kekyo/Pixy/Pixy-68000/Pixy-68000-1/Images/Pixy-68000-1-sch.pdf

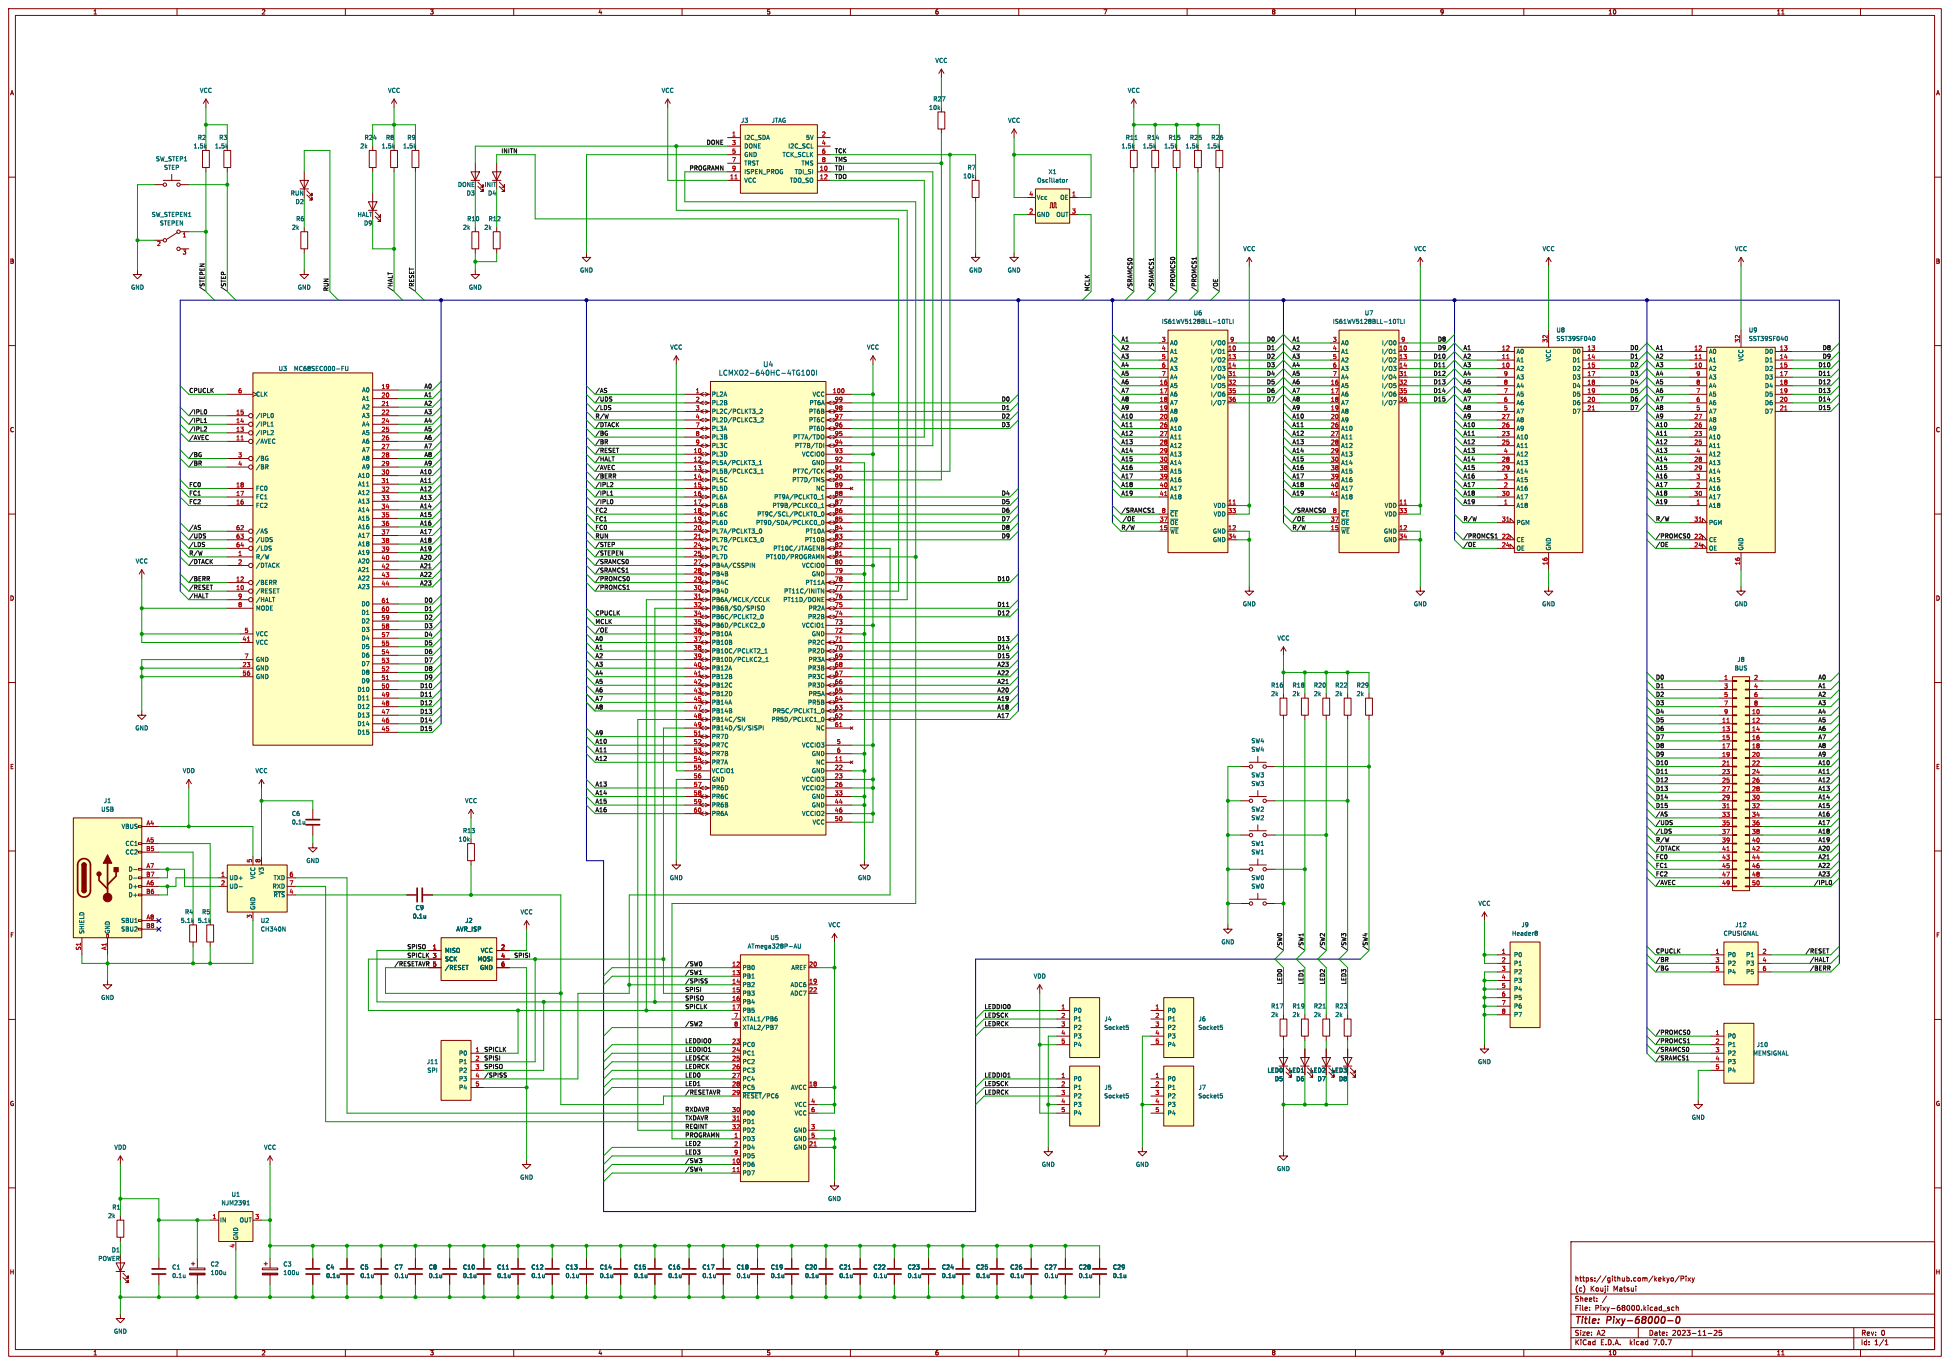
[picture p28: page 1]
