kekyo/Pixy/Pixy-68000/Pixy-68000-0/Images/Pixy-68000-0-sch.pdf

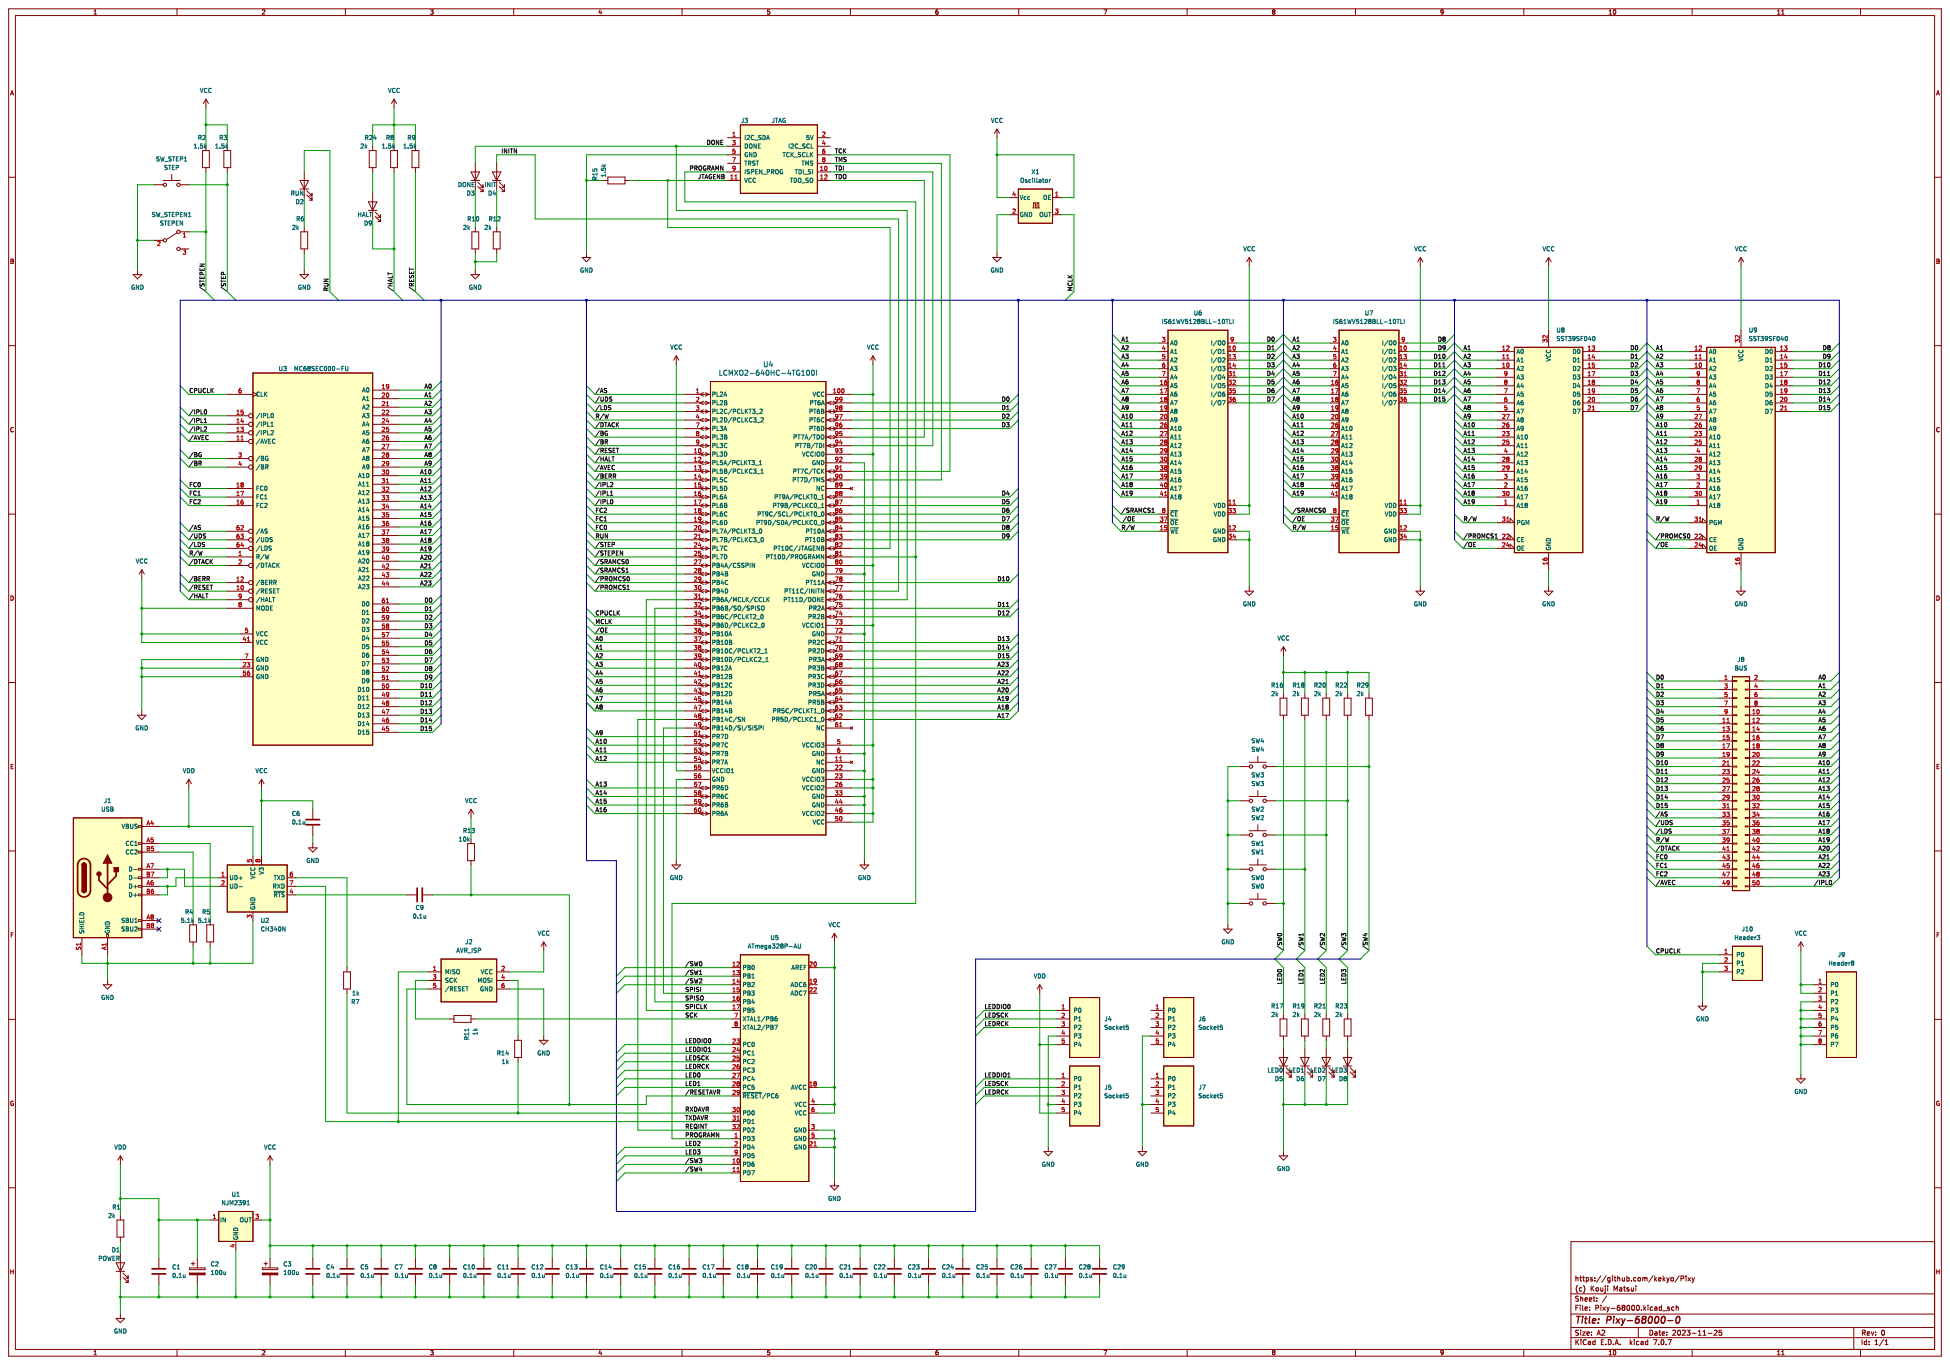
[picture p29: page 1]
