kekyo/Pixy/Pixy-68000/Pixy-68020-0/KiCad/Pixy-68020.kicad_pcb

## KiCad design Pixy-68000/Pixy-68020-0/KiCad/Pixy-68020.kicad_pcb (2025-05-06)

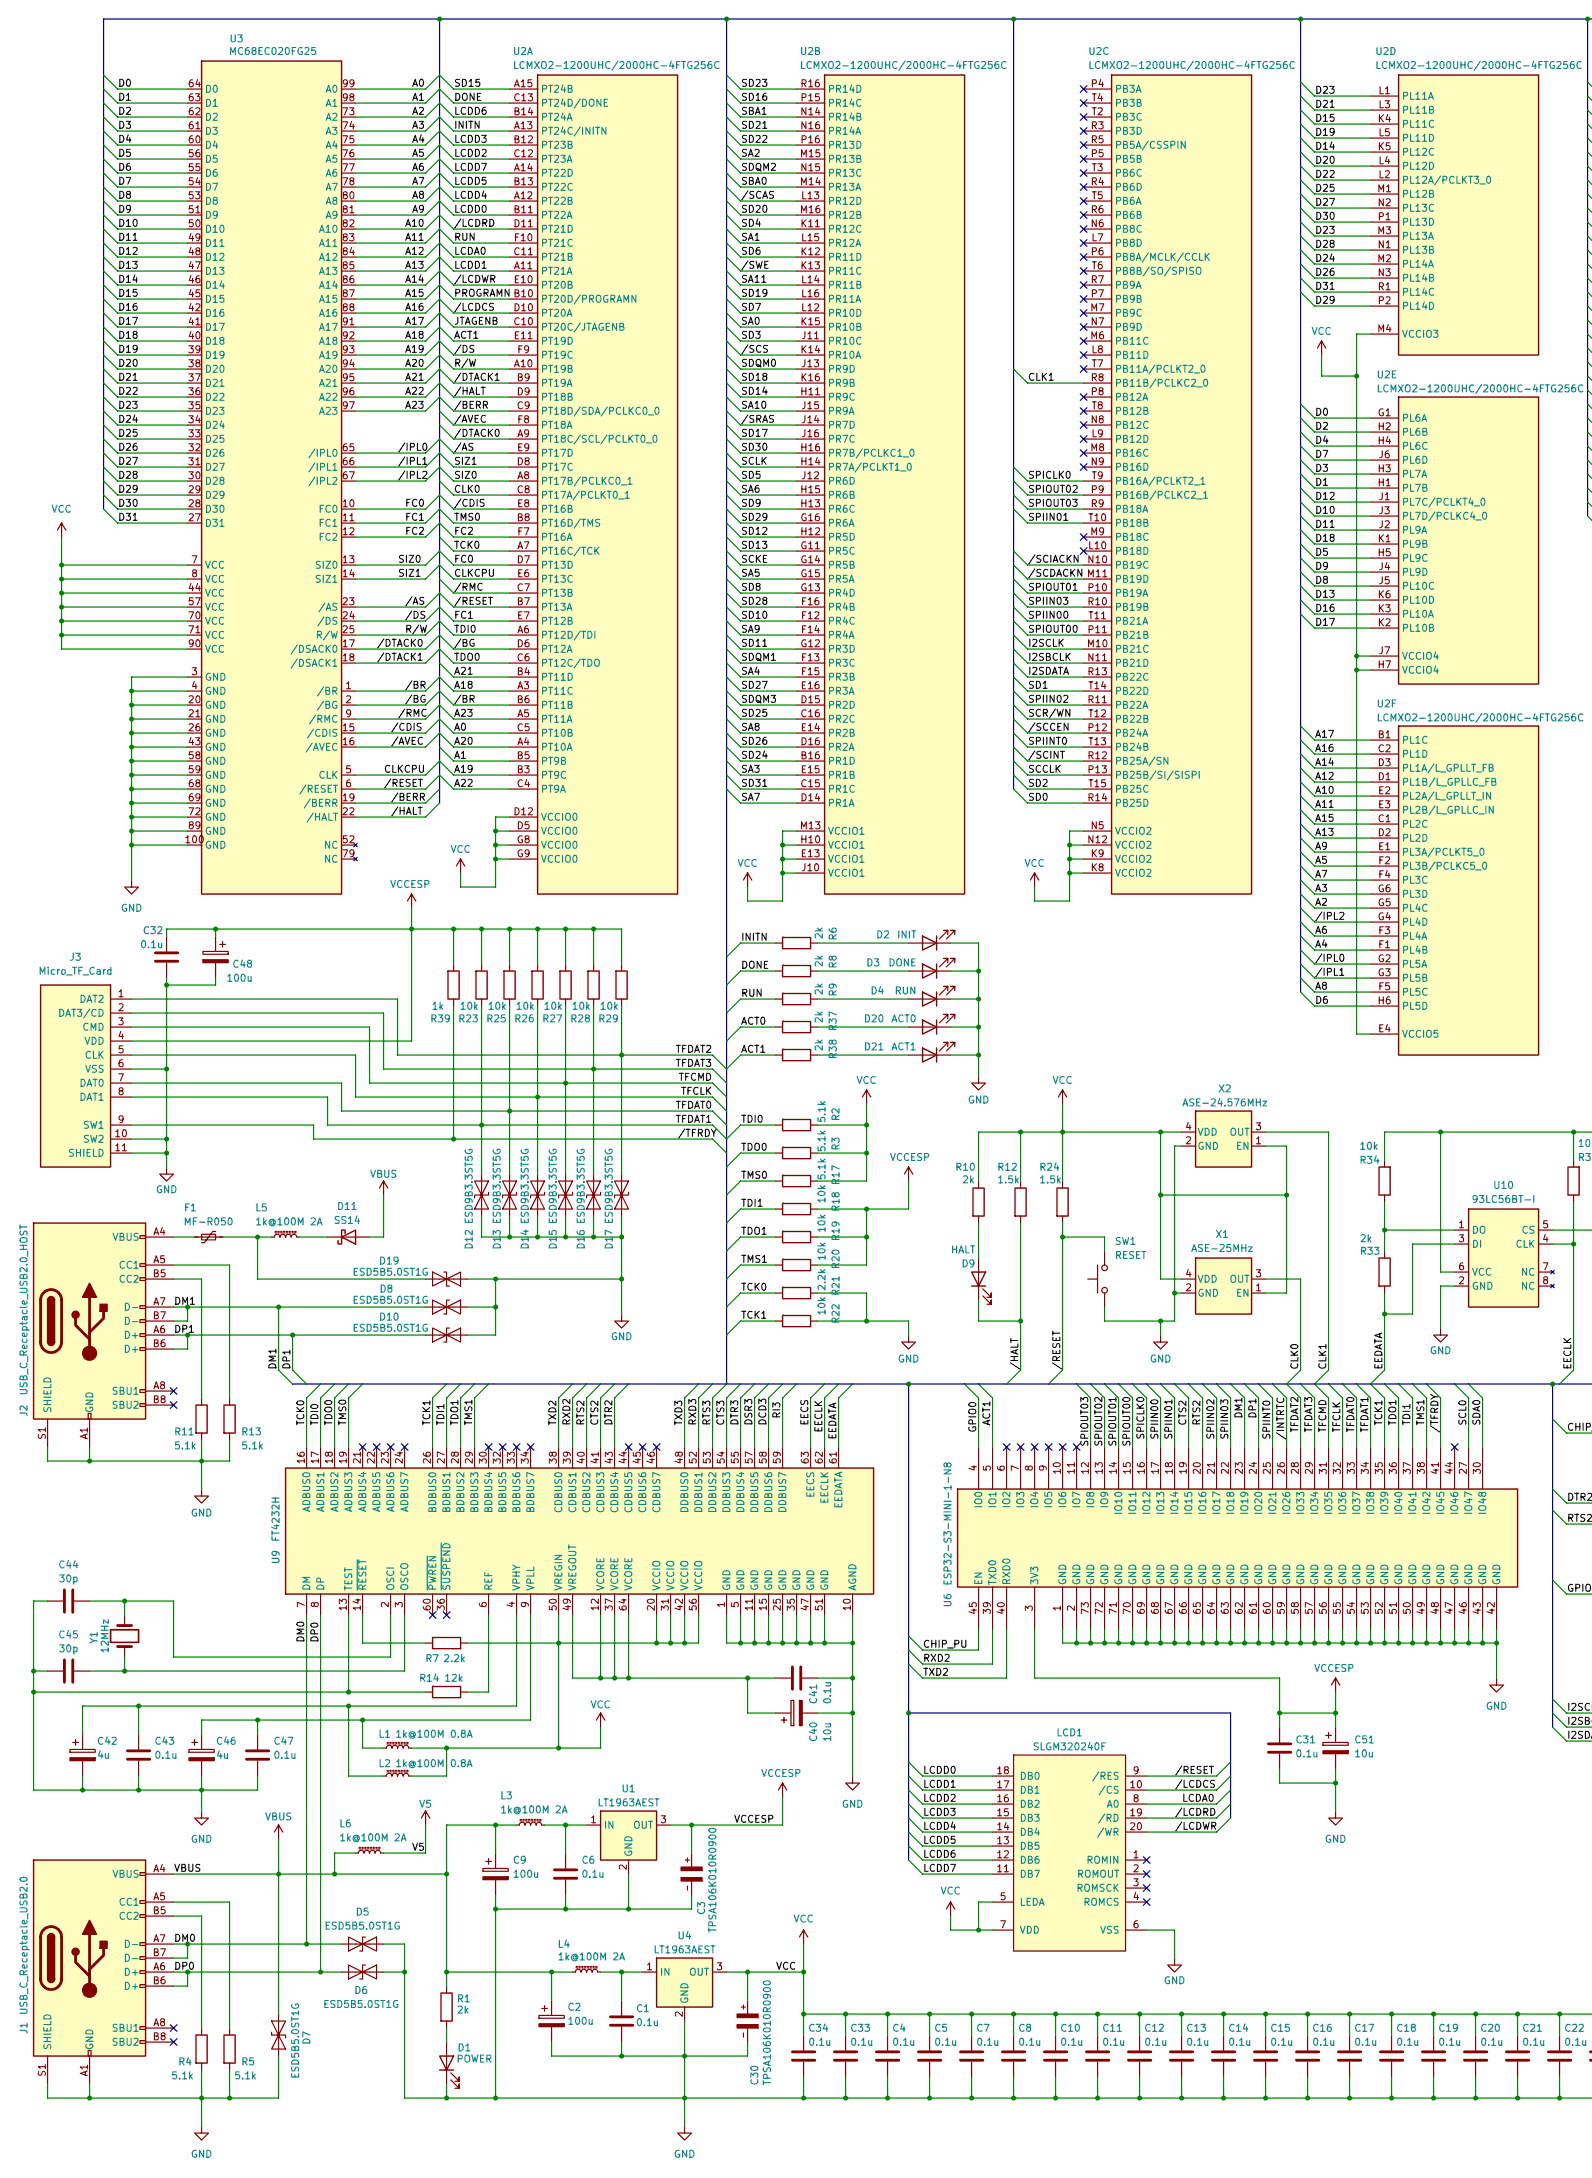
[picture p30: schematic Pixy-68020.kicad_sch, Pixy-68020-0, part in row 1, column 1]

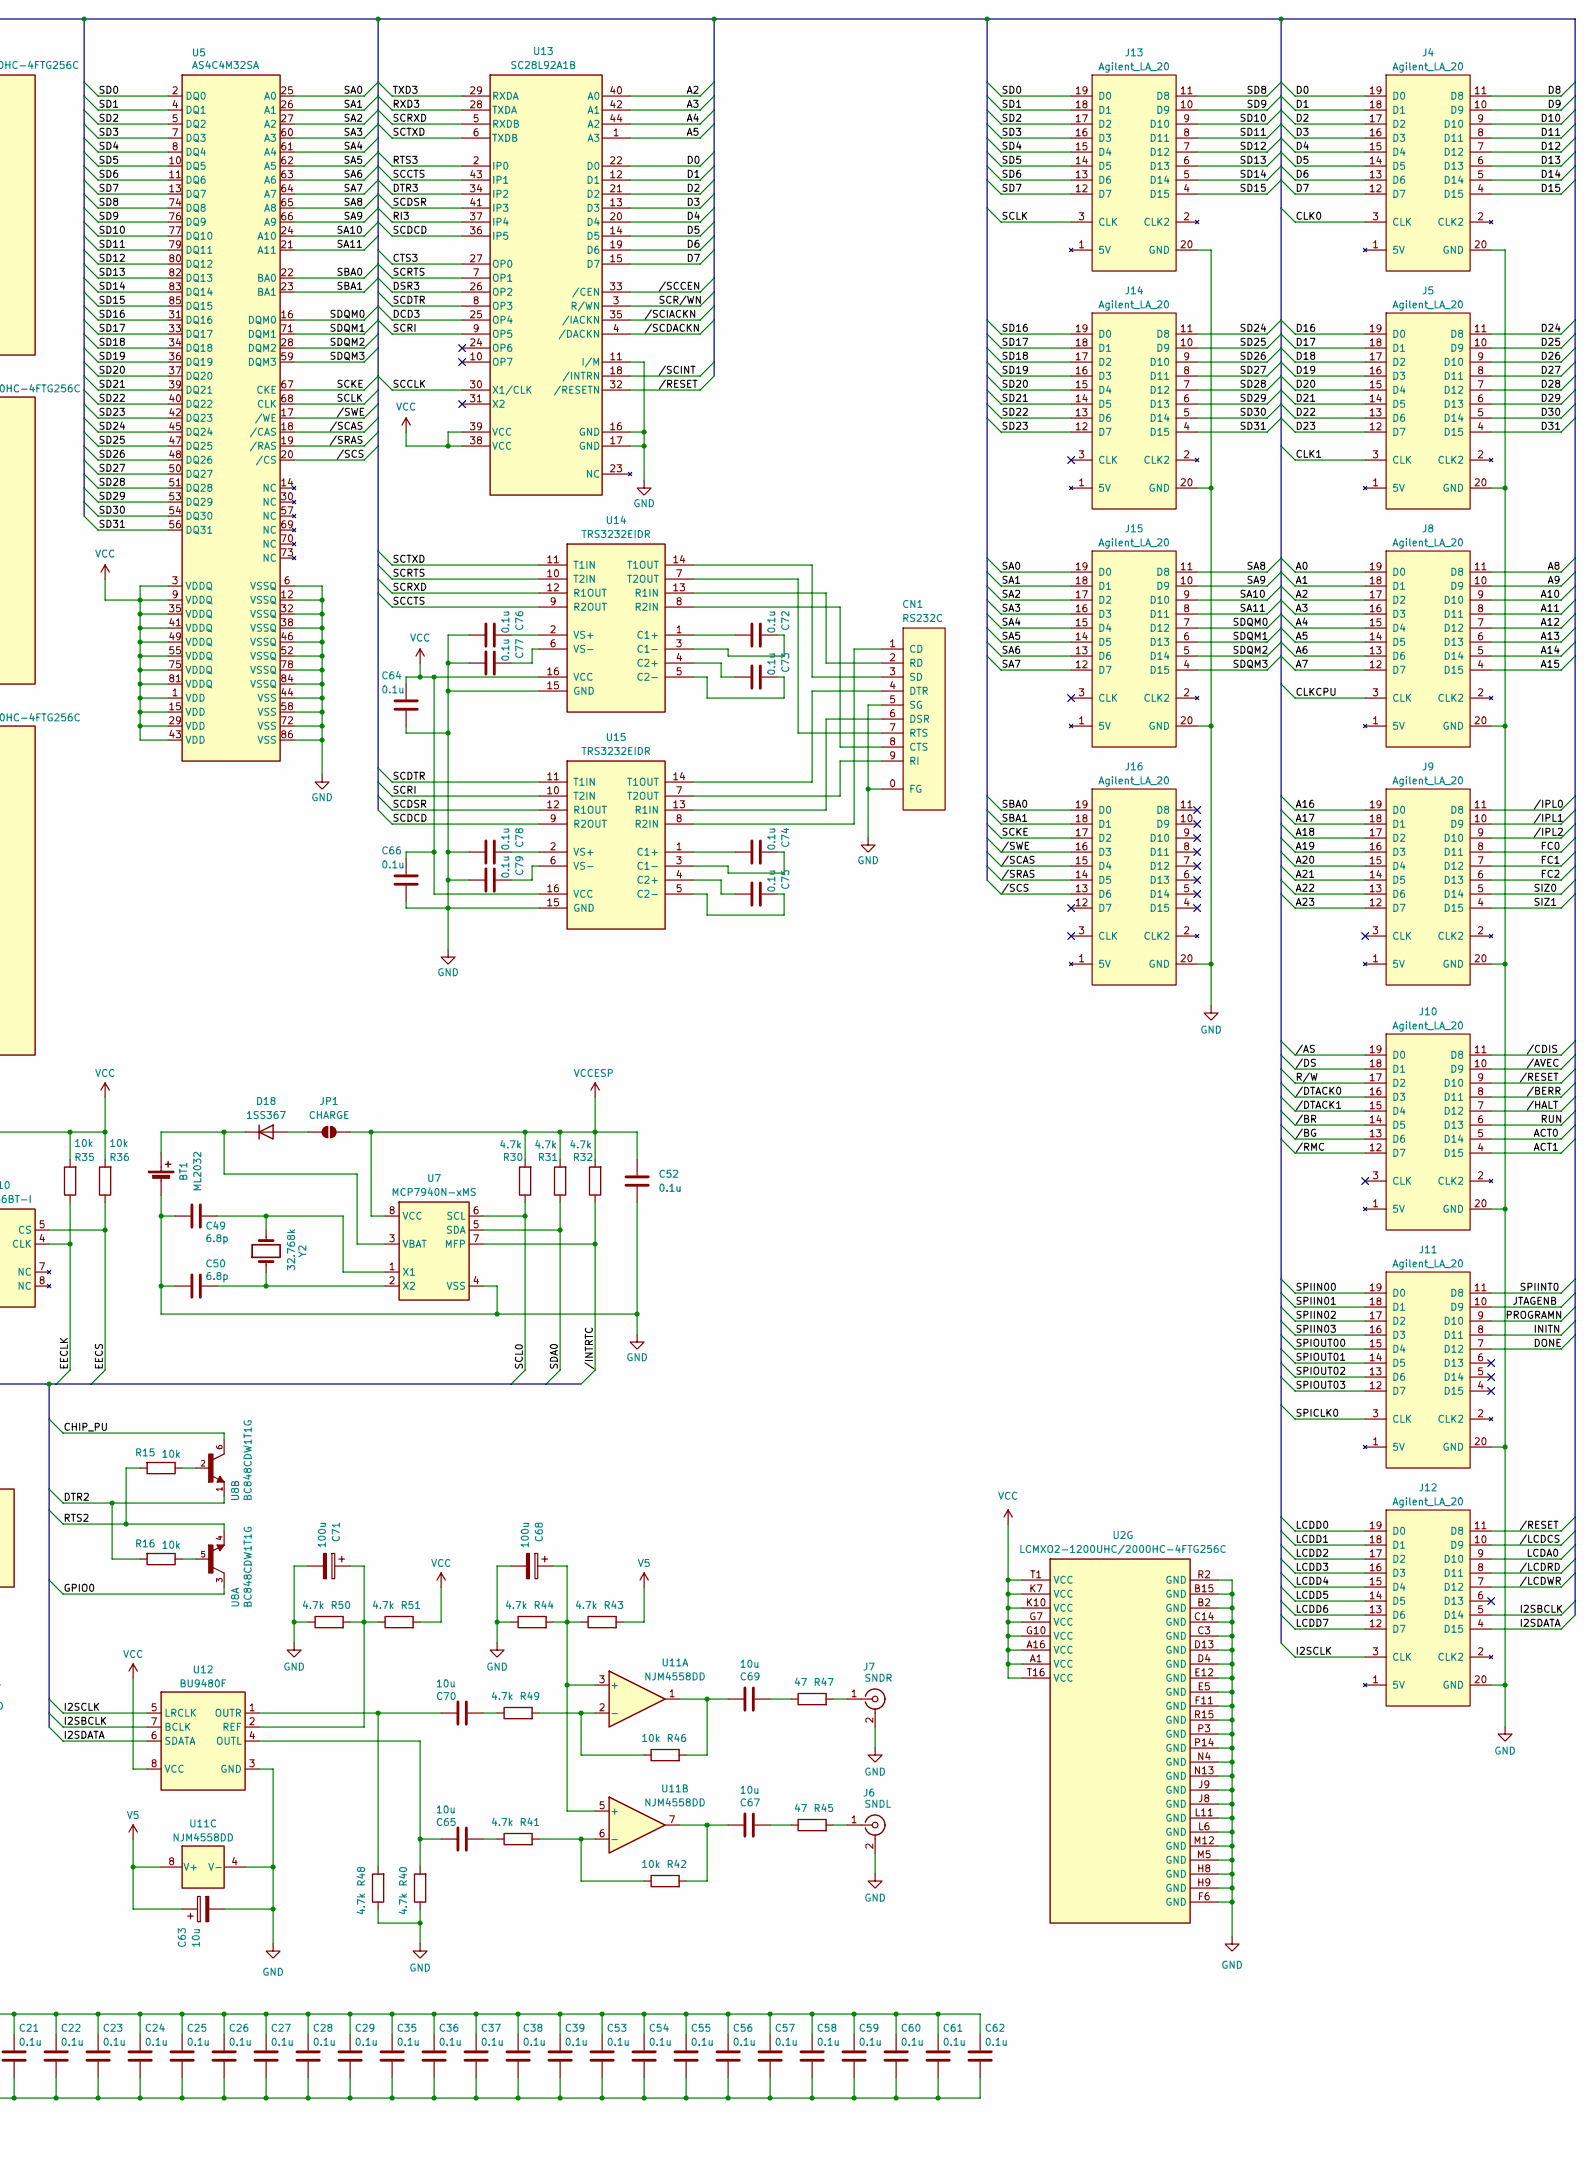
[picture p31: schematic Pixy-68020.kicad_sch, Pixy-68020-0, part in row 1, column 2]

Parts:
BT1: ML2032; BatteryHolder_Keystone_103_1x20mm
C1, C4, C5, C6, C7, C8, C10, C11, C12, C13, C14, C15, C16, C17, C18, C19, C20, C21, C22, C23, C24, C25, C26, C27, C28, C29, C31, C32, C33, C34, C35, C36, C37, C38, C39, C41, C43, C47, C52, C53, C54, C55, C56, C57, C58, C59, C60, C61, C62, C64, C66, C72, C73, C74, C75, C76, C77, C78, C79: 0.1u; C_0805_2012
C2, C9, C48, C68, C71: 100u; CP_Radial_D5.0mm_P2.50mm
C3, C30: TPSA106K010R0900; CAPMP3216X166
C40, C51, C63: 10u; CP_Radial_D5.0mm_P2.50mm
C42, C46: 4u; CP_Radial_D5.0mm_P2.50mm
C44, C45: 30p; C_0805_2012
C49, C50: 6.8p; C_0805_2012
C65, C67, C69, C70: 10u; C_0805_2012
CN1: RS232C; DSUB-9_Pins_Horizontal_P2.77x2.84mm_EdgePinOffset4.94mm_Hou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
D1: POWER; LED_D3.0mm
D2: INIT; LED_D3.0mm
D3: DONE; LED_D3.0mm
D4: RUN; LED_D3.0mm
D5, D6, D7, D8, D10, D19: ESD5B5.0ST1G; D_SOD-523
D9: HALT; LED_D3.0mm
D11: SS14; D_SMA
D12, D13, D14, D15, D16, D17: ESD9B3.3ST5G; D_SOD-923
D18: 1SS367; D_SOD-323F
D20: ACT0; LED_D3.0mm
D21: ACT1; LED_D3.0mm
F1: MF-R050; Fuse_Bourns_MF-RG300
J1: USB_C_Receptacle_USB2.0; USB_C_Receptacle_HRO_TYPE-C-31-M-12
J2: USB_C_Receptacle_USB2.0_HOST; USB_C_Receptacle_HRO_TYPE-C-31-M-12
J3: Micro_TF_Card; Hirose_DM3D-SF
J4, J5, J8, J9, J10, J11, J12, J13, J14, J15, J16: Agilent_LA_20; PinHeader_2x10_P2.54mm_Vertical
J6: SNDL; CUI_RCJ-042
J7: SNDR; CUI_RCJ-042
JP1: CHARGE; SolderJumper-2_P1.3mm_Open_RoundedPad1.0x1.5mm
L1, L2: 1k@100M 0.8A; L_0603_1608
L3, L4, L5, L6: 1k@100M 2A; L_1206_3216
LCD1: SLGM320240F; PinHeader_1x20_P2.54mm_Vertical
R1, R6, R8, R9, R10, R33, R37, R38: 2k; R_0805_2012
R2, R3, R4, R5, R11, R13, R17: 5.1k; R_0805_2012
R7, R21: 2.2k; R_0805_2012
R12, R24: 1.5k; R_0805_2012
R14: 12k; R_0805_2012
R15, R16, R18, R19, R20, R22, R23, R25, R26, R27, R28, R29, R34, R35, R36, R42, R46: 10k; R_0805_2012
R30, R31, R32, R40, R41, R43, R44, R48, R49, R50, R51: 4.7k; R_0805_2012
R39: 1k; R_0805_2012
R45, R47: 47; R_0805_2012
SW1: RESET; TactSwitch
U1, U4: LT1963AEST; SOT-223-3_TabPin2
U2: LCMXO2-1200UHC/2000HC-4FTG256C; LCMXO2-FTG256
U3: MC68EC020FG25
U5: AS4C4M32SA; SOIC-86
U6: ESP32-S3-MINI-1-N8; ESP32-S3-MINI-1_EXP
U7: MCP7940N-xMS; MSOP-8_3x3mm_P0.65mm
U8: BC848CDW1T1G; SOT65P210X110-6N
U9: FT4232H; LQFP-64_10x10mm_P0.5mm
U10: 93LC56BT-I; MSOP-8_3x3mm_P0.65mm
U11: NJM4558DD; DIP-8_W7.62mm
U12: BU9480F; SOP-8_3.9x4.9mm_P1.27mm
U13: SC28L92A1B; SOT307-2_NXP-M
U14, U15: TRS3232EIDR; SOIC-16_3.9x9.9mm_P1.27mm
X1: ASE-25MHz; Oscillator_SMD_Abracon_ASE-4Pin_3.2x2.5mm_HandSoldering
X2: ASE-24.576MHz; Oscillator_SMD_Abracon_ASE-4Pin_3.2x2.5mm_HandSoldering
Y1: 12MHz; Crystal_HC18-U_Vertical
Y2: 32.768k; Crystal_HC18-U_Vertical

Connections:
/A0: J8.19 (D0), U2.C5 (PT10B), U3.99 (A0)
/A1: J8.18 (D1), U2.B5 (PT9B), U3.98 (A1)
/A2: J8.17 (D2), U2.G5 (PL4C), U3.73 (A2), U13.40 (A0)
/A3: J8.16 (D3), U2.G6 (PL3D), U3.74 (A3), U13.42 (A1)
/A4: J8.15 (D4), U2.F1 (PL4B), U3.75 (A4), U13.44 (A2)
/A5: J8.14 (D5), U2.F2 (PL3B/PCLKC5_0), U3.76 (A5), U13.1 (A3)
/A6: J8.13 (D6), U2.F3 (PL4A), U3.77 (A6)
/A7: J8.12 (D7), U2.F4 (PL3C), U3.78 (A7)
/A8: J8.11 (D8), U2.F5 (PL5C), U3.80 (A8)
/A9: J8.10 (D9), U2.E1 (PL3A/PCLKT5_0), U3.81 (A9)
/A10: J8.9 (D10), U2.E2 (PL2A/L_GPLLT_IN), U3.82 (A10)
/A11: J8.8 (D11), U2.E3 (PL2B/L_GPLLC_IN), U3.83 (A11)
/A12: J8.7 (D12), U2.D1 (PL1B/L_GPLLC_FB), U3.84 (A12)
/A13: J8.6 (D13), U2.D2 (PL2D), U3.85 (A13)
/A14: J8.5 (D14), U2.D3 (PL1A/L_GPLLT_FB), U3.86 (A14)
/A15: J8.4 (D15), U2.C1 (PL2C), U3.87 (A15)
/A16: J9.19 (D0), U2.C2 (PL1D), U3.88 (A16)
/A17: J9.18 (D1), U2.B1 (PL1C), U3.91 (A17)
/A18: J9.17 (D2), U2.A3 (PT11C), U3.92 (A18)
/A19: J9.16 (D3), U2.B3 (PT9C), U3.93 (A19)
/A20: J9.15 (D4), U2.A4 (PT10A), U3.94 (A20)
/A21: J9.14 (D5), U2.B4 (PT11D), U3.95 (A21)
/A22: J9.13 (D6), U2.C4 (PT9A), U3.96 (A22)
/A23: J9.12 (D7), U2.A5 (PT11A), U3.97 (A23)
/ACT0: J10.5 (D14), R37.2
/ACT1: J10.4 (D15), R38.2, U2.E11 (PT19D), U6.5 (IO1)
/CHIP_PU: U6.45 (EN), U8.6
/CLK0: J4.3 (CLK), U2.C8 (PT17A/PCLKT0_1), X1.3 (OUT)
/CLK1: J5.3 (CLK), U2.R8 (PB11B/PCLKC2_0), X2.3 (OUT)
/CLKCPU: J8.3 (CLK), U2.E6 (PT13C), U3.5 (CLK)
/CTS2: U6.19 (IO15), U9.41 (CDBUS3)
/CTS3: U9.54 (DDBUS3), U13.27 (OP0)
/D0: J4.19 (D0), U2.G1 (PL6A), U3.64 (D0), U13.22 (D0)
/D1: J4.18 (D1), U2.H1 (PL7B), U3.63 (D1), U13.12 (D1)
/D2: J4.17 (D2), U2.H2 (PL6B), U3.62 (D2), U13.21 (D2)
/D3: J4.16 (D3), U2.H3 (PL7A), U3.61 (D3), U13.13 (D3)
/D4: J4.15 (D4), U2.H4 (PL6C), U3.60 (D4), U13.20 (D4)
/D5: J4.14 (D5), U2.H5 (PL9C), U3.56 (D5), U13.14 (D5)
/D6: J4.13 (D6), U2.H6 (PL5D), U3.55 (D6), U13.19 (D6)
/D7: J4.12 (D7), U2.J6 (PL6D), U3.54 (D7), U13.15 (D7)
/D8: J4.11 (D8), U2.J5 (PL10C), U3.53 (D8)
/D9: J4.10 (D9), U2.J4 (PL9D), U3.51 (D9)
/D10: J4.9 (D10), U2.J3 (PL7D/PCLKC4_0), U3.50 (D10)
/D11: J4.8 (D11), U2.J2 (PL9A), U3.49 (D11)
/D12: J4.7 (D12), U2.J1 (PL7C/PCLKT4_0), U3.48 (D12)
/D13: J4.6 (D13), U2.K6 (PL10D), U3.47 (D13)
/D14: J4.5 (D14), U2.K5 (PL12C), U3.46 (D14)
/D15: J4.4 (D15), U2.K4 (PL11C), U3.45 (D15)
/D16: J5.19 (D0), U2.K3 (PL10A), U3.42 (D16)
/D17: J5.18 (D1), U2.K2 (PL10B), U3.41 (D17)
/D18: J5.17 (D2), U2.K1 (PL9B), U3.40 (D18)
/D19: J5.16 (D3), U2.L5 (PL11D), U3.39 (D19)
/D20: J5.15 (D4), U2.L4 (PL12D), U3.38 (D20)
/D21: J5.14 (D5), U2.L3 (PL11B), U3.37 (D21)
/D22: J5.13 (D6), U2.L2 (PL12A/PCLKT3_0), U3.36 (D22)
/D23: J5.12 (D7), U2.L1 (PL11A), U2.M3 (PL13A), U3.35 (D23)
/D24: J5.11 (D8), U2.M2 (PL14A), U3.34 (D24)
/D25: J5.10 (D9), U2.M1 (PL12B), U3.33 (D25)
/D26: J5.9 (D10), U2.N3 (PL14B), U3.32 (D26)
/D27: J5.8 (D11), U2.N2 (PL13C), U3.31 (D27)
/D28: J5.7 (D12), U2.N1 (PL13B), U3.30 (D28)
/D29: J5.6 (D13), U2.P2 (PL14D), U3.29 (D29)
/D30: J5.5 (D14), U2.P1 (PL13D), U3.28 (D30)
/D31: J5.4 (D15), U2.R1 (PL14C), U3.27 (D31)
/DCD3: U9.58 (DDBUS6), U13.25 (OP4)
/DM0: D5.1 (A1), J1.A7 (D-), J1.B7 (D-), U9.7 (DM)
/DM1: D8.1 (A1), J2.A7 (D-), J2.B7 (D-), U6.23 (IO19)
/DONE: J11.7 (D12), R8.2, U2.C13 (PT24D/DONE)
/DP0: D6.1 (A1), J1.A6 (D+), J1.B6 (D+), U9.8 (DP)
/DP1: D10.1 (A1), J2.A6 (D+), J2.B6 (D+), U6.24 (IO20)
/DSR3: U9.57 (DDBUS5), U13.26 (OP2)
/DTR2: R16.2, U8.1, U9.43 (CDBUS4)
/DTR3: U9.55 (DDBUS4), U13.34 (IP2)
/EECLK: R35.1, U9.62 (EECLK), U10.4 (CLK)
/EECS: R36.1, U9.63 (EECS), U10.5 (CS)
/EEDATA: R33.2, U9.61 (EEDATA), U10.3 (DI)
/FC0: J9.8 (D11), U2.D7 (PT13D), U3.10 (FC0)
/FC1: J9.7 (D12), U2.E7 (PT12B), U3.11 (FC1)
/FC2: J9.6 (D13), U2.F7 (PT16A), U3.12 (FC2)
/GPIO0: U6.4 (IO0), U8.3
/I2SBCLK: J12.5 (D14), U2.N11 (PB21D), U12.7 (BCLK)
/I2SCLK: J12.3 (CLK), U2.M10 (PB21C), U12.5 (LRCLK)
/I2SDATA: J12.4 (D15), U2.R13 (PB22C), U12.6 (SDATA)
/INITN: J11.8 (D11), R6.2, U2.A13 (PT24C/INITN)
/JTAGENB: J11.10 (D9), U2.C10 (PT20C/JTAGENB)
/LCDA0: J12.9 (D10), LCD1.8 (A0), U2.C11 (PT21B)
/LCDD0: J12.19 (D0), LCD1.18 (DB0), U2.B11 (PT22A)
/LCDD1: J12.18 (D1), LCD1.17 (DB1), U2.A11 (PT21A)
/LCDD2: J12.17 (D2), LCD1.16 (DB2), U2.C12 (PT23A)
/LCDD3: J12.16 (D3), LCD1.15 (DB3), U2.B12 (PT23B)
/LCDD4: J12.15 (D4), LCD1.14 (DB4), U2.A12 (PT22B)
/LCDD5: J12.14 (D5), LCD1.13 (DB5), U2.B13 (PT22C)
/LCDD6: J12.13 (D6), LCD1.12 (DB6), U2.B14 (PT24A)
/LCDD7: J12.12 (D7), LCD1.11 (DB7), U2.A14 (PT22D)
/RI3: U9.59 (DDBUS7), U13.37 (IP4)
/RTS2: R15.2, U6.20 (IO16), U8.4, U9.40 (CDBUS2)
/RTS3: U9.53 (DDBUS2), U13.2 (IP0)
/RUN: J10.6 (D13), R9.2, U2.F10 (PT21C)
/RXD2: U6.39 (TXD0), U9.39 (CDBUS1)
/RXD3: U9.52 (DDBUS1), U13.28 (TXDA)
/R/W: J10.17 (D2), U2.A10 (PT19B), U3.25 (R/W)
/SA0: J15.19 (D0), U2.K15 (PR10B), U5.25 (A0)
/SA1: J15.18 (D1), U2.L15 (PR12A), U5.26 (A1)
/SA2: J15.17 (D2), U2.M15 (PR13B), U5.27 (A2)
/SA3: J15.16 (D3), U2.E15 (PR1B), U5.60 (A3)
/SA4: J15.15 (D4), U2.F15 (PR3B), U5.61 (A4)
/SA5: J15.14 (D5), U2.G15 (PR5A), U5.62 (A5)
/SA6: J15.13 (D6), U2.H15 (PR6B), U5.63 (A6)
/SA7: J15.12 (D7), U2.D14 (PR1A), U5.64 (A7)
/SA8: J15.11 (D8), U2.E14 (PR2B), U5.65 (A8)
/SA9: J15.10 (D9), U2.F14 (PR4A), U5.66 (A9)
/SA10: J15.9 (D10), U2.J15 (PR9A), U5.24 (A10)
/SA11: J15.8 (D11), U2.L14 (PR11B), U5.21 (A11)
/SBA0: J16.19 (D0), U2.M14 (PR13A), U5.22 (BA0)
/SBA1: J16.18 (D1), U2.N14 (PR14B), U5.23 (BA1)
/SCCLK: U2.P13 (PB25B/SI/SISPI), U13.30 (X1/CLK)
/SCCTS: U13.43 (IP1), U14.9 (R2OUT)
/SCDCD: U13.36 (IP5), U15.9 (R2OUT)
/SCDSR: U13.41 (IP3), U15.12 (R1OUT)
/SCDTR: U13.8 (OP3), U15.11 (T1IN)
/SCKE: J16.17 (D2), U2.G14 (PR5B), U5.67 (CKE)
/SCL0: R30.1, U6.27 (IO47), U7.6 (SCL)
/SCLK: J13.3 (CLK), U2.H14 (PR7A/PCLKT1_0), U5.68 (CLK)
/SCRI: U13.9 (OP5), U15.10 (T2IN)
/SCRTS: U13.7 (OP1), U14.10 (T2IN)
/SCRXD: U13.5 (RXDB), U14.12 (R1OUT)
/SCR/WN: U2.T12 (PB22B), U13.3 (R/WN)
/SCTXD: U13.6 (TXDB), U14.11 (T1IN)
/SD0: J13.19 (D0), U2.R14 (PB25D), U5.2 (DQ0)
/SD1: J13.18 (D1), U2.T14 (PB22D), U5.4 (DQ1)
/SD2: J13.17 (D2), U2.T15 (PB25C), U5.5 (DQ2)
/SD3: J13.16 (D3), U2.J11 (PR10C), U5.7 (DQ3)
/SD4: J13.15 (D4), U2.K11 (PR12C), U5.8 (DQ4)
/SD5: J13.14 (D5), U2.J12 (PR6D), U5.10 (DQ5)
/SD6: J13.13 (D6), U2.K12 (PR11D), U5.11 (DQ6)
/SD7: J13.12 (D7), U2.L12 (PR10D), U5.13 (DQ7)
/SD8: J13.11 (D8), U2.G13 (PR4D), U5.74 (DQ8)
/SD9: J13.10 (D9), U2.H13 (PR6C), U5.76 (DQ9)
/SD10: J13.9 (D10), U2.F12 (PR4C), U5.77 (DQ10)
/SD11: J13.8 (D11), U2.G12 (PR3D), U5.79 (DQ11)
/SD12: J13.7 (D12), U2.H12 (PR5D), U5.80 (DQ12)
/SD13: J13.6 (D13), U2.G11 (PR5C), U5.82 (DQ13)
/SD14: J13.5 (D14), U2.H11 (PR9C), U5.83 (DQ14)
/SD15: J13.4 (D15), U2.A15 (PT24B), U5.85 (DQ15)
/SD16: J14.19 (D0), U2.P15 (PR14C), U5.31 (DQ16)
/SD17: J14.18 (D1), U2.J16 (PR7C), U5.33 (DQ17)
/SD18: J14.17 (D2), U2.K16 (PR9B), U5.34 (DQ18)
/SD19: J14.16 (D3), U2.L16 (PR11A), U5.36 (DQ19)
/SD20: J14.15 (D4), U2.M16 (PR12B), U5.37 (DQ20)
/SD21: J14.14 (D5), U2.N16 (PR14A), U5.39 (DQ21)
/SD22: J14.13 (D6), U2.P16 (PR13D), U5.40 (DQ22)
/SD23: J14.12 (D7), U2.R16 (PR14D), U5.42 (DQ23)
/SD24: J14.11 (D8), U2.B16 (PR1D), U5.45 (DQ24)
/SD25: J14.10 (D9), U2.C16 (PR2C), U5.47 (DQ25)
/SD26: J14.9 (D10), U2.D16 (PR2A), U5.48 (DQ26)
/SD27: J14.8 (D11), U2.E16 (PR3A), U5.50 (DQ27)
/SD28: J14.7 (D12), U2.F16 (PR4B), U5.51 (DQ28)
/SD29: J14.6 (D13), U2.G16 (PR6A), U5.53 (DQ29)
/SD30: J14.5 (D14), U2.H16 (PR7B/PCLKC1_0), U5.54 (DQ30)
/SD31: J14.4 (D15), U2.C15 (PR1C), U5.56 (DQ31)
/SDA0: R31.1, U6.30 (IO48), U7.5 (SDA)
/SDQM0: J15.7 (D12), U2.J13 (PR9D), U5.16 (DQM0)
/SDQM1: J15.6 (D13), U2.F13 (PR3C), U5.71 (DQM1)
/SDQM2: J15.5 (D14), U2.N15 (PR13C), U5.28 (DQM2)
/SDQM3: J15.4 (D15), U2.D15 (PR2D), U5.59 (DQM3)
/SIZ0: J9.5 (D14), U2.A8 (PT17B/PCLKC0_1), U3.13 (SIZ0)
/SIZ1: J9.4 (D15), U2.D8 (PT17C), U3.14 (SIZ1)
/SPICLK0: J11.3 (CLK), U2.T9 (PB16A/PCLKT2_1), U6.16 (IO12)
/SPIIN00: J11.19 (D0), U2.T11 (PB21A), U6.17 (IO13)
/SPIIN01: J11.18 (D1), U2.T10 (PB18B), U6.18 (IO14)
/SPIIN02: J11.17 (D2), U2.R11 (PB22A), U6.21 (IO17)
/SPIIN03: J11.16 (D3), U2.R10 (PB19B), U6.22 (IO18)
/SPIINT0: J11.11 (D8), U2.T13 (PB24B), U6.25 (IO21)
/SPIOUT00: J11.15 (D4), U2.P11 (PB21B), U6.15 (IO11)
/SPIOUT01: J11.14 (D5), U2.P10 (PB19A), U6.14 (IO10)
/SPIOUT02: J11.13 (D6), U2.P9 (PB16B/PCLKC2_1), U6.13 (IO9)
/SPIOUT03: J11.12 (D7), U2.R9 (PB18A), U6.12 (IO8)
/TCK0: R21.2, U2.A7 (PT16C/TCK), U9.16 (ADBUS0)
/TCK1: R22.2, U6.35 (IO39), U9.26 (BDBUS0)
/TDI0: R2.2, U2.A6 (PT12D/TDI), U9.17 (ADBUS1)
/TDI1: R18.2, U6.37 (IO41), U9.27 (BDBUS1)
/TDO0: R3.2, U2.C6 (PT12C/TDO), U9.18 (ADBUS2)
/TDO1: R19.2, U6.36 (IO40), U9.28 (BDBUS2)
/TFCLK: D14.1 (A1), J3.5 (CLK), R26.1, U6.32 (IO36)
/TFCMD: D15.1 (A1), J3.3 (CMD), R27.1, U6.31 (IO35)
/TFDAT0: D13.1 (A1), J3.7 (DAT0), R25.1, U6.33 (IO37)
/TFDAT1: D12.1 (A1), J3.8 (DAT1), R23.1, U6.34 (IO38)
/TFDAT2: D17.1 (A1), J3.1 (DAT2), R29.1, U6.28 (IO33)
/TFDAT3: D16.1 (A1), J3.2 (DAT3/CD), R28.1, U6.29 (IO34)
/TMS0: R17.2, U2.B8 (PT16D/TMS), U9.19 (ADBUS3)
/TMS1: R20.2, U6.38 (IO42), U9.29 (BDBUS3)
/TXD2: U6.40 (RXD0), U9.38 (CDBUS0)
/TXD3: U9.48 (DDBUS0), U13.29 (RXDA)
//AS: J10.19 (D0), U2.E9 (PT17D), U3.23 (/AS)
//AVEC: J10.10 (D9), U2.F8 (PT18A), U3.16 (/AVEC)
//BERR: J10.8 (D11), U2.C9 (PT18D/SDA/PCLKC0_0), U3.19 (/BERR)
//BG: J10.13 (D6), U2.D6 (PT12A), U3.2 (/BG)
//BR: J10.14 (D5), U2.B6 (PT11B), U3.1 (/BR)
//CDIS: J10.11 (D8), U2.E8 (PT16B), U3.15 (/CDIS)
//DS: J10.18 (D1), U2.F9 (PT19C), U3.24 (/DS)
//DTACK0: J10.16 (D3), U2.A9 (PT18C/SCL/PCLKT0_0), U3.17 (/DSACK0)
//DTACK1: J10.15 (D4), U2.B9 (PT19A), U3.18 (/DSACK1)
//HALT: D9.1 (K), J10.7 (D12), R12.2, U2.D9 (PT18B), U3.22 (/HALT)
//INTRTC: R32.1, U6.26 (IO26), U7.7 (MFP)
//IPL0: J9.11 (D8), U2.G2 (PL5A), U3.65 (/IPL0)
//IPL1: J9.10 (D9), U2.G3 (PL5B), U3.66 (/IPL1)
//IPL2: J9.9 (D10), U2.G4 (PL4D), U3.67 (/IPL2)
//LCDCS: J12.10 (D9), LCD1.10 (/CS), U2.D10 (PT20A)
//LCDRD: J12.8 (D11), LCD1.19 (/RD), U2.D11 (PT21D)
//LCDWR: J12.7 (D12), LCD1.20 (/WR), U2.E10 (PT20B)
//RESET: J10.9 (D10), J12.11 (D8), LCD1.9 (/RES), R24.2, SW1.2, U2.B7 (PT13A), U3.6 (/RESET), U13.32 (/RESETN)
//RMC: J10.12 (D7), U2.C7 (PT13B), U3.9 (/RMC)
//SCAS: J16.15 (D4), U2.L13 (PR12D), U5.18 (/CAS)
//SCCEN: U2.P12 (PB24A), U13.33 (/CEN)
//SCDACKN: U2.M11 (PB19D), U13.4 (/DACKN)
//SCIACKN: U2.N10 (PB19C), U13.35 (/IACKN)
//SCINT: U2.R12 (PB25A/SN), U13.18 (/INTRN)
//SCS: J16.13 (D6), U2.K14 (PR10A), U5.20 (/CS)
//SRAS: J16.14 (D5), U2.J14 (PR7D), U5.19 (/RAS)
//SWE: J16.16 (D3), U2.K13 (PR11C), U5.17 (/WE)
//TFRDY: J3.9 (SW1), R39.1, U6.41 (IO45)
GND: BT1.2 (-), C1.2, C2.2, C3.-, C4.2, C5.2, C6.2, C7.2, C8.2, C9.2, C10.2, C11.2, C12.2, C13.2, C14.2, C15.2, C16.2, C17.2, C18.2, C19.2, C20.2, C21.2, C22.2, C23.2, C24.2, C25.2, C26.2, C27.2, C28.2, C29.2, C30.-, C31.2, C32.2, C33.2, C34.2, C35.2, C36.2, C37.2, C38.2, C39.2, C40.2, C41.2, C42.2, C43.2, C44.2, C45.2, C46.2, C47.2, C48.2, C49.2, C50.2, C51.2, C52.2, C53.2, C54.2, C55.2, C56.2, C57.2, C58.2, C59.2, C60.2, C61.2, C62.2, C63.2, C64.2, C66.2, C68.2, C71.2, C76.2, C77.2, C78.2, C79.2, CN1.0 (FG), CN1.5 (SG), D1.1 (K), D2.1 (K), D3.1 (K), D4.1 (K), D5.2 (A2), D6.2 (A2), D7.2 (A2), D8.2 (A2), D10.2 (A2), D12.2 (A2), D13.2 (A2), D14.2 (A2), D15.2 (A2), D16.2 (A2), D17.2 (A2), D19.1 (A1), D20.1 (K), D21.1 (K), J1.A1 (GND), J1.A12 (GND), J1.B1 (GND), J1.B12 (GND), J1.S1 (SHIELD), J2.A1 (GND), J2.A12 (GND), J2.B1 (GND), J2.B12 (GND), J2.S1 (SHIELD), J3.6 (VSS), J3.10 (SW2), J3.11 (SHIELD), J4.20 (GND), J5.20 (GND), J6.2 (Ext), J7.2 (Ext), J8.20 (GND), J9.20 (GND), J10.20 (GND), J11.9 (D10), J11.20 (GND), J12.20 (GND), J13.20 (GND), J14.20 (GND), J15.20 (GND), J16.20 (GND), LCD1.6 (VSS), R4.2, R5.2, R11.2, R13.2, R14.2, R21.1, R22.1, R40.1, R44.1, R48.1, R50.1, SW1.1, U1.2 (GND), U2.B2 (GND), U2.B10 (PT20D/PROGRAMN), U2.B15 (GND), U2.C3 (GND), U2.C14 (GND), U2.D4 (GND), U2.D13 (GND), U2.E5 (GND), U2.E12 (GND), U2.F6 (GND), U2.F11 (GND), U2.H8 (GND), U2.H9 (GND), U2.J8 (GND), U2.J9 (GND), U2.L6 (GND), U2.L11 (GND), U2.M5 (GND), U2.M12 (GND), U2.N4 (GND), U2.N13 (GND), U2.P3 (GND), U2.P14 (GND), U2.R2 (GND), U2.R15 (GND), U3.3 (GND), U3.4 (GND), U3.20 (GND), U3.21 (GND), U3.26 (GND), U3.43 (GND), U3.58 (GND), U3.59 (GND), U3.68 (GND), U3.69 (GND), U3.72 (GND), U3.89 (GND), U3.100 (GND), U4.2 (GND), U5.6 (VSSQ), U5.12 (VSSQ), U5.32 (VSSQ), U5.38 (VSSQ), U5.44 (VSS), U5.46 (VSSQ), U5.52 (VSSQ), U5.58 (VSS), U5.72 (VSS), U5.78 (VSSQ), U5.84 (VSSQ), U5.86 (VSS), U6.1 (GND), U6.2 (GND), U6.42 (GND), U6.43 (GND), U6.46 (GND), U6.47 (GND), U6.48 (GND), U6.49 (GND), U6.50 (GND), U6.51 (GND), U6.52 (GND), U6.53 (GND), U6.54 (GND), U6.55 (GND), U6.56 (GND), U6.57 (GND), U6.58 (GND), U6.59 (GND), U6.60 (GND), U6.61 (GND), U6.62 (GND), U6.63 (GND), U6.64 (GND), U6.65 (GND), U6.66 (GND), U6.67 (GND), U6.68 (GND), U6.69 (GND), U6.70 (GND), U6.71 (GND), U6.72 (GND), U6.73 (GND), U7.4 (VSS), U9.1 (GND), U9.5 (GND), U9.10 (AGND), U9.11 (GND), U9.13 (TEST), U9.15 (GND), U9.25 (GND), U9.35 (GND), U9.47 (GND), U9.51 (GND), U10.2 (GND), U11.4 (V-), U12.3 (GND), U13.11 (I/M), U13.16 (GND), U13.17 (GND), U14.15 (GND), U15.15 (GND), X1.2 (GND), X2.2 (GND)
unnamed: BT1.1 (+), D18.1 (K), U7.3 (VBAT)
unnamed: C65.1, R41.1
unnamed: C67.1, R45.1
unnamed: C67.2, R42.2, U11.7
unnamed: C69.1, R47.1
unnamed: C69.2, R46.2, U11.1
unnamed: C70.1, R49.1
unnamed: CN1.1 (CD), U15.8 (R2IN)
unnamed: CN1.8 (CTS), U14.8 (R2IN)
unnamed: CN1.6 (DSR), U15.13 (R1IN)
unnamed: CN1.4 (DTR), U15.14 (T1OUT)
unnamed: CN1.2 (RD), U14.13 (R1IN)
unnamed: CN1.9 (RI), U15.7 (T2OUT)
unnamed: CN1.7 (RTS), U14.7 (T2OUT)
unnamed: CN1.3 (SD), U14.14 (T1OUT)
unnamed: D1.2 (A), R1.2
unnamed: D2.2 (A), R6.1
unnamed: D3.2 (A), R8.1
unnamed: D4.2 (A), R9.1
unnamed: D9.2 (A), R10.2
unnamed: D11.1 (K), L5.1
unnamed: D18.2 (A), JP1.1 (A)
unnamed: D19.2 (A2), F1.1, L5.2
unnamed: D20.2 (A), R37.1
unnamed: D21.2 (A), R38.1
unnamed: F1.2, J2.A4 (VBUS), J2.A9 (VBUS), J2.B4 (VBUS), J2.B9 (VBUS)
unnamed: J1.A5 (CC1), R5.1
unnamed: J1.B5 (CC2), R4.1
unnamed: J2.A5 (CC1), R13.1
unnamed: J2.B5 (CC2), R11.1
unnamed: J6.1 (In), R45.2
unnamed: J7.1 (In), R47.2
unnamed: R15.1, U8.2
unnamed: R16.1, U8.5
unnamed: C6.1, L3.1, U1.1 (IN)
unnamed: C1.1, L4.1, U4.1 (IN)
unnamed: C49.1, U7.1 (X1), Y2.2
unnamed: C50.1, U7.2 (X2), Y2.1
unnamed: C44.1, U9.2 (OSCI), Y1.2
unnamed: C45.1, U9.3 (OSCO), Y1.1
unnamed: R14.1, U9.6 (REF)
unnamed: C42.1, C43.1, L2.2, U9.4 (VPHY)
unnamed: C46.1, C47.1, L1.2, U9.9 (VPLL)
unnamed: C40.1, C41.1, U9.12 (VCORE), U9.37 (VCORE), U9.49 (VREGOUT), U9.64 (VCORE)
unnamed: R7.1, U9.14 (~RESET)
unnamed: R33.1, R34.1, U10.1 (DO)
unnamed: C68.1, R43.1, R44.2, U11.3 (+), U11.5 (+)
unnamed: R46.1, R49.2, U11.2 (-)
unnamed: R41.2, R42.1, U11.6 (-)
unnamed: C65.2, R40.2, U12.4 (OUTL)
unnamed: C70.2, R48.2, U12.1 (OUTR)
unnamed: C71.1, R50.2, R51.1, U12.2 (REF)
unnamed: C72.2, U14.1 (C1+)
unnamed: C72.1, U14.3 (C1-)
unnamed: C73.2, U14.4 (C2+)
unnamed: C73.1, U14.5 (C2-)
unnamed: C76.1, U14.2 (VS+)
unnamed: C77.1, U14.6 (VS-)
unnamed: C74.2, U15.1 (C1+)
unnamed: C74.1, U15.3 (C1-)
unnamed: C75.2, U15.4 (C2+)
unnamed: C75.1, U15.5 (C2-)
unnamed: C78.1, U15.2 (VS+)
unnamed: C79.1, U15.6 (VS-)
V5: C63.1, L6.1, R43.2, U11.8 (V+)
VBUS: C2.1, C9.1, D7.1 (A1), D11.2 (A), J1.A4 (VBUS), J1.A9 (VBUS), J1.B4 (VBUS), J1.B9 (VBUS), L3.2, L4.2, L6.2, R1.1
VCC: C4.1, C5.1, C7.1, C8.1, C10.1, C11.1, C12.1, C13.1, C14.1, C15.1, C16.1, C17.1, C18.1, C19.1, C20.1, C21.1, C22.1, C23.1, C24.1, C25.1, C26.1, C27.1, C28.1, C29.1, C30.+, C33.1, C34.1, C35.1, C36.1, C37.1, C38.1, C39.1, C53.1, C54.1, C55.1, C56.1, C57.1, C58.1, C59.1, C60.1, C61.1, C62.1, C64.1, C66.1, L1.1, L2.1, LCD1.5 (LEDA), LCD1.7 (VDD), R2.1, R3.1, R7.2, R10.1, R12.1, R17.1, R24.1, R34.2, R35.2, R36.2, R51.2, U2.A1 (VCC), U2.A16 (VCC), U2.D5 (VCCIO0), U2.D12 (VCCIO0), U2.E4 (VCCIO5), U2.E13 (VCCIO1), U2.G7 (VCC), U2.G8 (VCCIO0), U2.G9 (VCCIO0), U2.G10 (VCC), U2.H7 (VCCIO4), U2.H10 (VCCIO1), U2.J7 (VCCIO4), U2.J10 (VCCIO1), U2.K7 (VCC), U2.K8 (VCCIO2), U2.K9 (VCCIO2), U2.K10 (VCC), U2.M4 (VCCIO3), U2.M13 (VCCIO1), U2.N5 (VCCIO2), U2.N12 (VCCIO2), U2.T1 (VCC), U2.T16 (VCC), U3.7 (VCC), U3.8 (VCC), U3.44 (VCC), U3.57 (VCC), U3.70 (VCC), U3.71 (VCC), U3.90 (VCC), U4.3 (OUT), U5.1 (VDD), U5.3 (VDDQ), U5.9 (VDDQ), U5.15 (VDD), U5.29 (VDD), U5.35 (VDDQ), U5.41 (VDDQ), U5.43 (VDD), U5.49 (VDDQ), U5.55 (VDDQ), U5.75 (VDDQ), U5.81 (VDDQ), U9.20 (VCCIO), U9.31 (VCCIO), U9.42 (VCCIO), U9.50 (VREGIN), U9.56 (VCCIO), U10.6 (VCC), U12.8 (VCC), U13.38 (VCC), U13.39 (VCC), U14.16 (VCC), U15.16 (VCC), X1.1 (EN), X1.4 (VDD), X2.1 (EN), X2.4 (VDD)
VCCESP: C3.+, C31.1, C32.1, C48.1, C51.1, C52.1, J3.4 (VDD), JP1.2 (B), R18.1, R19.1, R20.1, R23.2, R25.2, R26.2, R27.2, R28.2, R29.2, R30.2, R31.2, R32.2, R39.2, U1.3 (OUT), U6.3 (3V3), U7.8 (VCC)

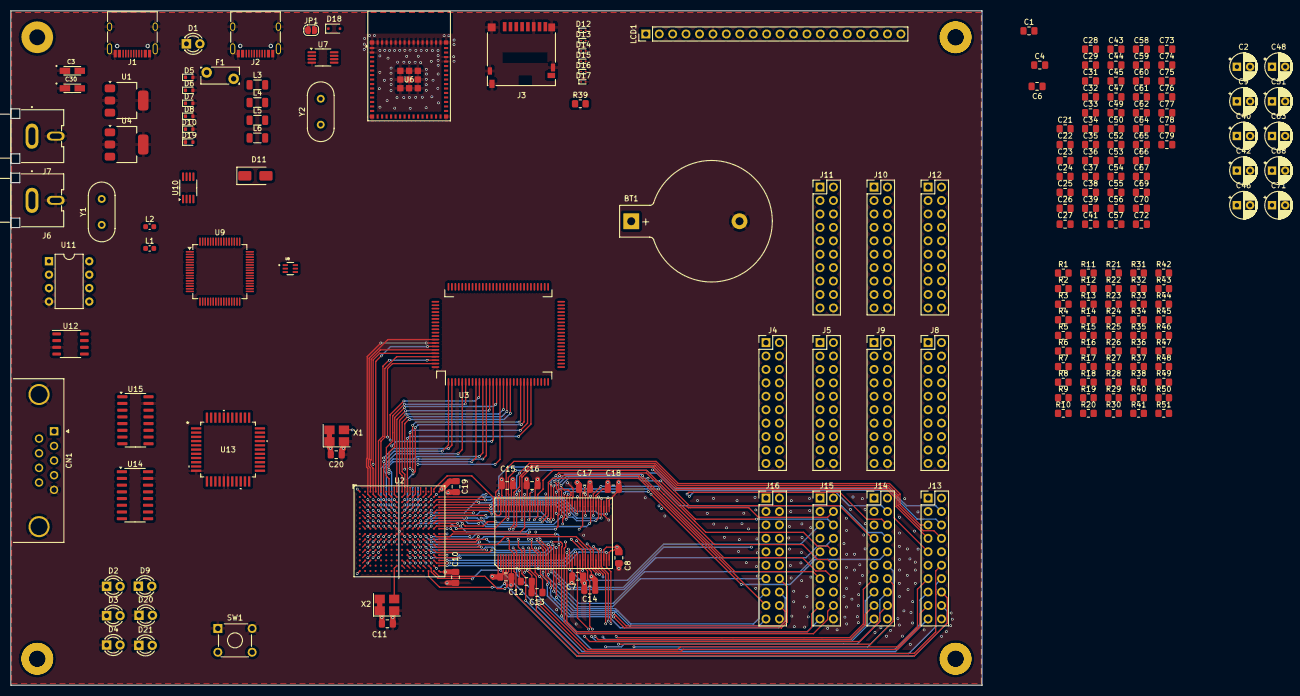
[picture p32: board Pixy-68020.kicad_pcb from above]

Board: 4 copper layers, 183.7 x 127.6 mm, 198 parts (0 on the bottom side), 290 nets.
