kekyo/Pixy/Pixy-mega128-sdram-hat/KiCad/Pixy-mega128-0-sdram-hat.kicad_pcb

## KiCad design Pixy-mega128-sdram-hat/KiCad/Pixy-mega128-0-sdram-hat.kicad_pcb (2023-11-04)

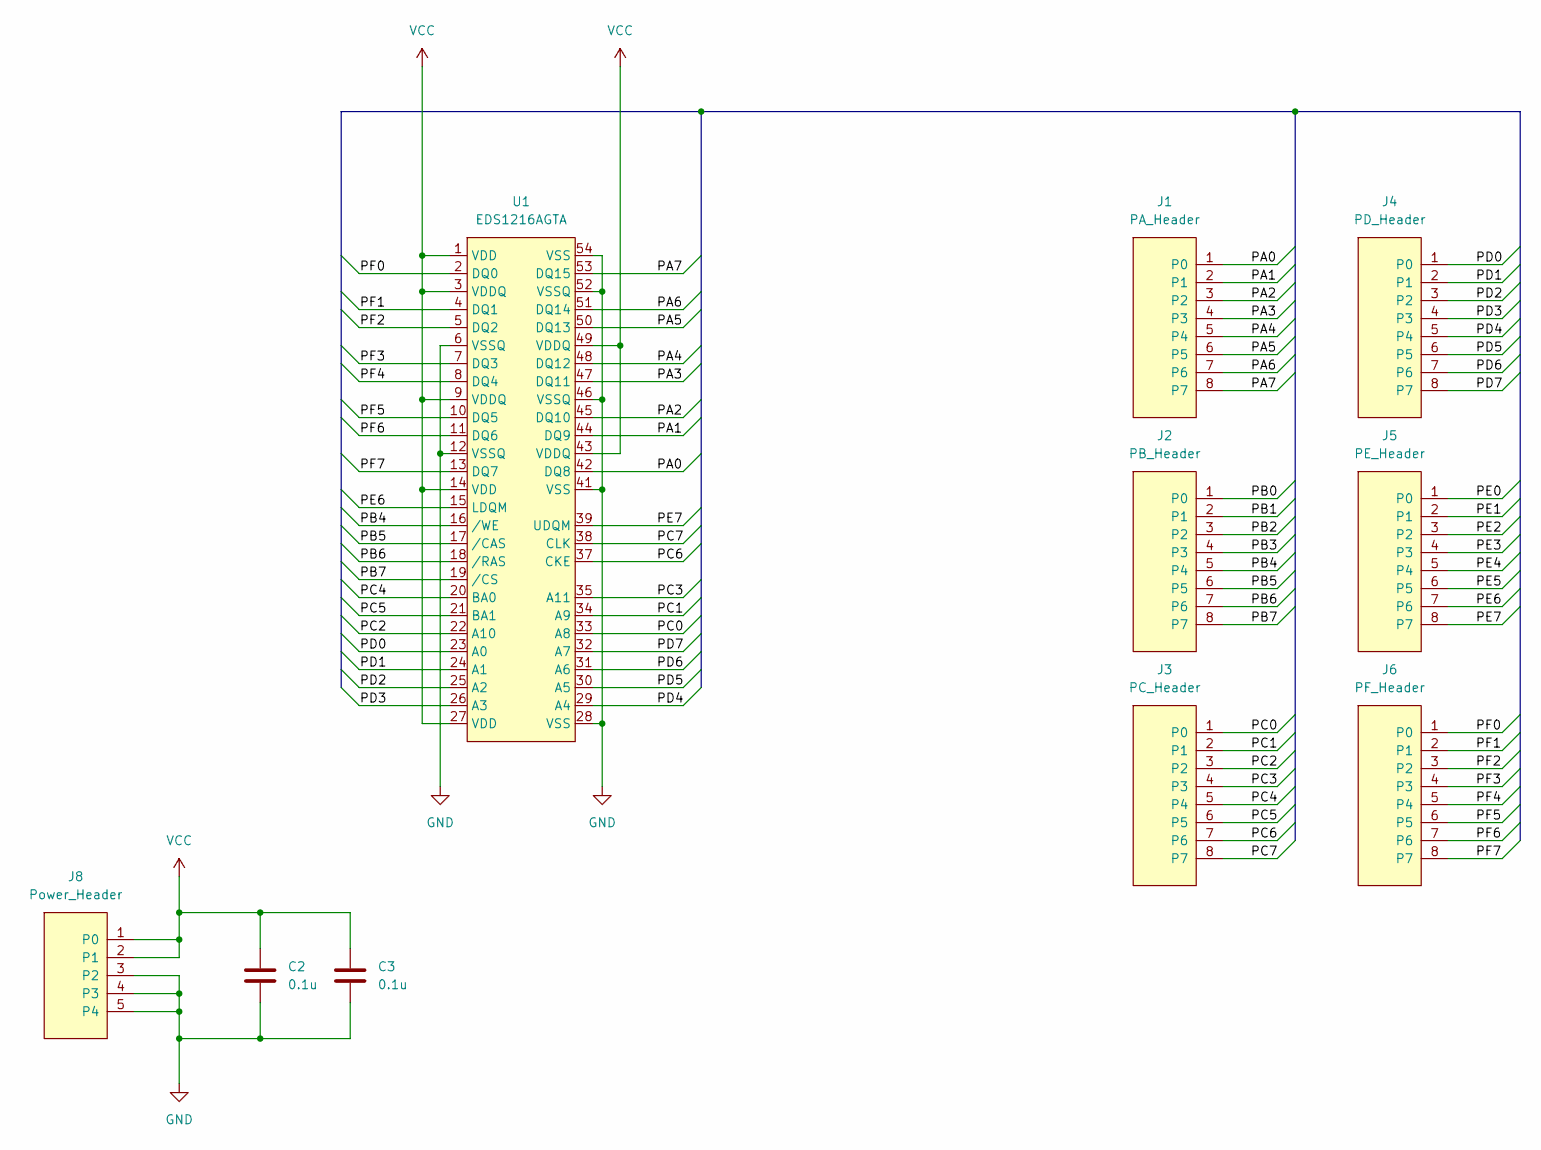
[picture p33: schematic Pixy-mega128-0-sdram-hat.kicad_sch]

Parts:
C2, C3: 0.1u; C_Disc_D4.3mm_W1.9mm_P5.00mm
J1: PA_Header; PinHeader_1x08_P2.54mm_Vertical
J2: PB_Header; PinHeader_1x08_P2.54mm_Vertical
J3: PC_Header; PinHeader_1x08_P2.54mm_Vertical
J4: PD_Header; PinHeader_1x08_P2.54mm_Vertical
J5: PE_Header; PinHeader_1x08_P2.54mm_Vertical
J6: PF_Header; PinHeader_1x08_P2.54mm_Vertical
J8: Power_Header; PinSocket_1x05_P2.54mm_Vertical
U1: EDS1216AGTA

Connections:
/PA0: J1.1 (P0), U1.42 (DQ8)
/PA1: J1.2 (P1), U1.44 (DQ9)
/PA2: J1.3 (P2), U1.45 (DQ10)
/PA3: J1.4 (P3), U1.47 (DQ11)
/PA4: J1.5 (P4), U1.48 (DQ12)
/PA5: J1.6 (P5), U1.50 (DQ13)
/PA6: J1.7 (P6), U1.51 (DQ14)
/PA7: J1.8 (P7), U1.53 (DQ15)
/PB0: J2.1 (P0)
/PB1: J2.2 (P1)
/PB2: J2.3 (P2)
/PB3: J2.4 (P3)
/PB4: J2.5 (P4), U1.16 (/WE)
/PB5: J2.6 (P5), U1.17 (/CAS)
/PB6: J2.7 (P6), U1.18 (/RAS)
/PB7: J2.8 (P7), U1.19 (/CS)
/PC0: J3.1 (P0), U1.33 (A8)
/PC1: J3.2 (P1), U1.34 (A9)
/PC2: J3.3 (P2), U1.22 (A10)
/PC3: J3.4 (P3), U1.35 (A11)
/PC4: J3.5 (P4), U1.20 (BA0)
/PC5: J3.6 (P5), U1.21 (BA1)
/PC6: J3.7 (P6), U1.37 (CKE)
/PC7: J3.8 (P7), U1.38 (CLK)
/PD0: J4.1 (P0), U1.23 (A0)
/PD1: J4.2 (P1), U1.24 (A1)
/PD2: J4.3 (P2), U1.25 (A2)
/PD3: J4.4 (P3), U1.26 (A3)
/PD4: J4.5 (P4), U1.29 (A4)
/PD5: J4.6 (P5), U1.30 (A5)
/PD6: J4.7 (P6), U1.31 (A6)
/PD7: J4.8 (P7), U1.32 (A7)
/PE0: J5.1 (P0)
/PE1: J5.2 (P1)
/PE2: J5.3 (P2)
/PE3: J5.4 (P3)
/PE4: J5.5 (P4)
/PE5: J5.6 (P5)
/PE6: J5.7 (P6), U1.15 (LDQM)
/PE7: J5.8 (P7), U1.39 (UDQM)
/PF0: J6.1 (P0), U1.2 (DQ0)
/PF1: J6.2 (P1), U1.4 (DQ1)
/PF2: J6.3 (P2), U1.5 (DQ2)
/PF3: J6.4 (P3), U1.7 (DQ3)
/PF4: J6.5 (P4), U1.8 (DQ4)
/PF5: J6.6 (P5), U1.10 (DQ5)
/PF6: J6.7 (P6), U1.11 (DQ6)
/PF7: J6.8 (P7), U1.13 (DQ7)
GND: C2.2, C3.2, J8.3 (P2), J8.4 (P3), J8.5 (P4), U1.6 (VSSQ), U1.12 (VSSQ), U1.28 (VSS), U1.41 (VSS), U1.46 (VSSQ), U1.52 (VSSQ), U1.54 (VSS)
VCC: C2.1, C3.1, J8.1 (P0), J8.2 (P1), U1.1 (VDD), U1.3 (VDDQ), U1.9 (VDDQ), U1.14 (VDD), U1.27 (VDD), U1.43 (VDDQ), U1.49 (VDDQ)

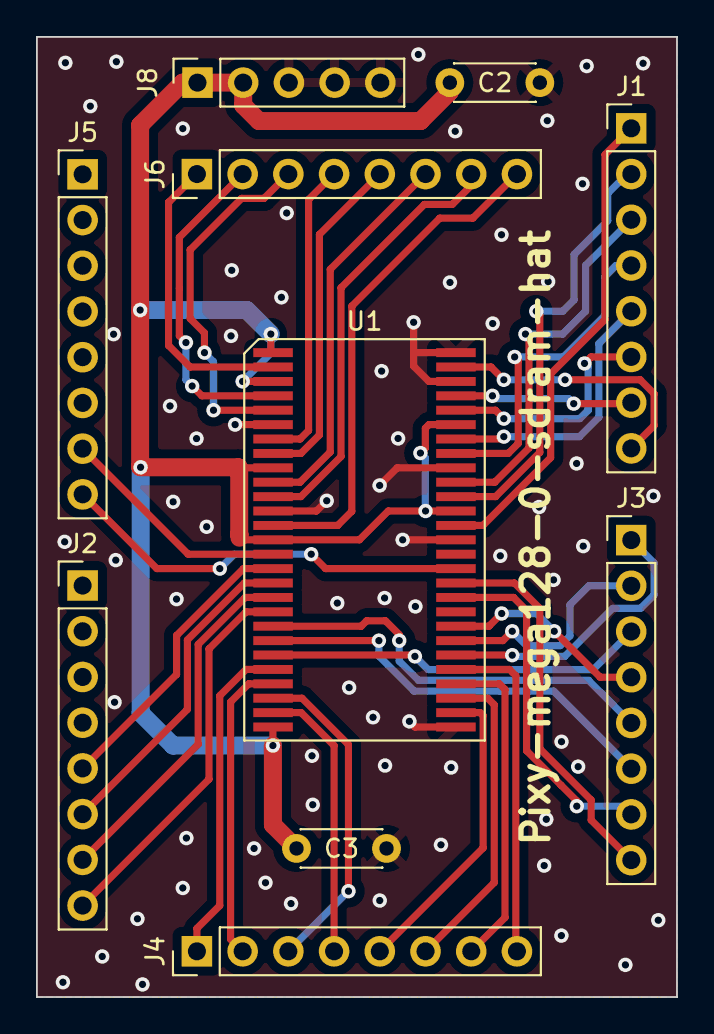
[picture p34: board Pixy-mega128-0-sdram-hat.kicad_pcb from above]

Board: 2 copper layers, 35.6 x 53.3 mm, 10 parts (0 on the bottom side), 40 nets.
