kekyo/Pixy/Pixy-mega128/KiCad/Pixy-mega128.kicad_pcb

## KiCad design Pixy-mega128/KiCad/Pixy-mega128.kicad_pcb (2023-10-29)

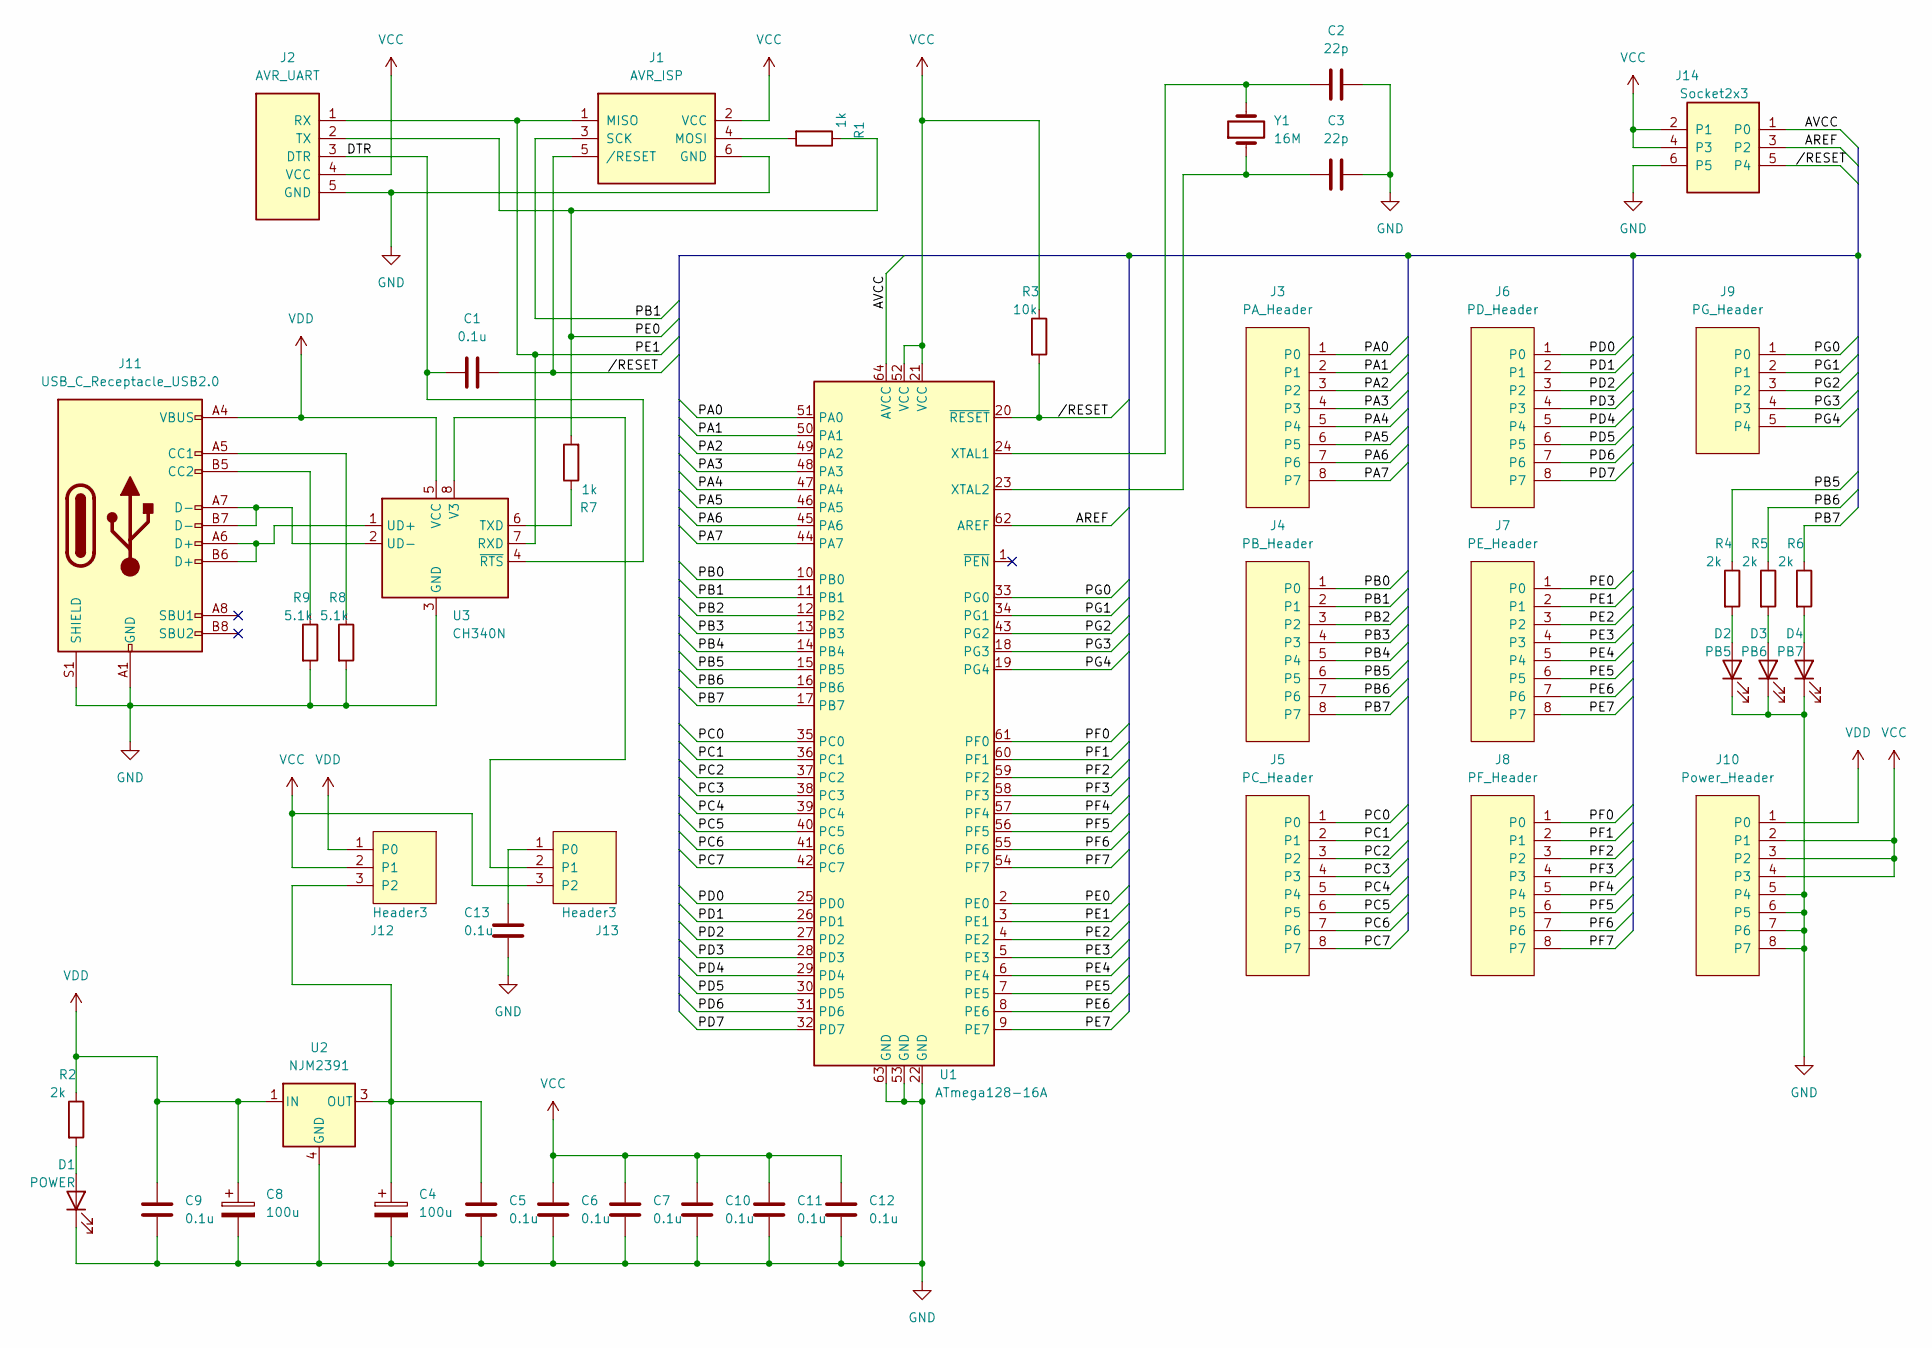
[picture p35: schematic Pixy-mega128.kicad_sch]

Parts:
C1, C5, C6, C7, C9, C10, C11, C12, C13: 0.1u; C_Disc_D4.3mm_W1.9mm_P5.00mm
C2, C3: 22p; C_Disc_D4.3mm_W1.9mm_P5.00mm
C4, C8: 100u; CP_Radial_D5.0mm_P2.50mm
D1: POWER; LED_D3.0mm
D2: PB5; LED_D3.0mm
D3: PB6; LED_D3.0mm
D4: PB7; LED_D3.0mm
J1: AVR_ISP; PinHeader_2x03_P2.54mm_Vertical
J2: AVR_UART; PinHeader_1x05_P2.54mm_Vertical
J3: PA_Header; PinHeader_1x08_P2.54mm_Vertical
J4: PB_Header; PinHeader_1x08_P2.54mm_Vertical
J5: PC_Header; PinHeader_1x08_P2.54mm_Vertical
J6: PD_Header; PinHeader_1x08_P2.54mm_Vertical
J7: PE_Header; PinHeader_1x08_P2.54mm_Vertical
J8: PF_Header; PinHeader_1x08_P2.54mm_Vertical
J9: PG_Header; PinSocket_1x05_P2.54mm_Vertical
J10: Power_Header; PinHeader_1x08_P2.54mm_Vertical
J11: USB_C_Receptacle_USB2.0; USB_C_Receptacle_HRO_TYPE-C-31-M-12
J12, J13: Header3; PinHeader_1x03_P2.54mm_Vertical
J14: Socket2x3; PinHeader_2x03_P2.54mm_Vertical
R1, R7: 1k; R_Axial_DIN0204_L3.6mm_D1.6mm_P2.54mm_Vertical
R2, R4, R5, R6: 2k; R_Axial_DIN0204_L3.6mm_D1.6mm_P2.54mm_Vertical
R3: 10k; R_Axial_DIN0204_L3.6mm_D1.6mm_P2.54mm_Vertical
R8, R9: 5.1k; R_Axial_DIN0204_L3.6mm_D1.6mm_P2.54mm_Vertical
U1: ATmega128-16A; QFP-64_AVR128
U2: NJM2391; TO-252-3_TabPin4
U3: CH340N; SOP-8_3.9x4.9mm_P1.27mm
Y1: 16M; Crystal_HC18-U_Vertical

Connections:
/AREF: J14.3 (P2), U1.62 (AREF)
/AVCC: J14.1 (P0), U1.64 (AVCC)
/DTR: C1.1, J2.3 (DTR), U3.4 (~RTS)
/PA0: J3.1 (P0), U1.51 (PA0)
/PA1: J3.2 (P1), U1.50 (PA1)
/PA2: J3.3 (P2), U1.49 (PA2)
/PA3: J3.4 (P3), U1.48 (PA3)
/PA4: J3.5 (P4), U1.47 (PA4)
/PA5: J3.6 (P5), U1.46 (PA5)
/PA6: J3.7 (P6), U1.45 (PA6)
/PA7: J3.8 (P7), U1.44 (PA7)
/PB0: J4.1 (P0), U1.10 (PB0)
/PB1: J1.3 (SCK), J4.2 (P1), U1.11 (PB1)
/PB2: J4.3 (P2), U1.12 (PB2)
/PB3: J4.4 (P3), U1.13 (PB3)
/PB4: J4.5 (P4), U1.14 (PB4)
/PB5: J4.6 (P5), R4.1, U1.15 (PB5)
/PB6: J4.7 (P6), R5.1, U1.16 (PB6)
/PB7: J4.8 (P7), R6.1, U1.17 (PB7)
/PC0: J5.1 (P0), U1.35 (PC0)
/PC1: J5.2 (P1), U1.36 (PC1)
/PC2: J5.3 (P2), U1.37 (PC2)
/PC3: J5.4 (P3), U1.38 (PC3)
/PC4: J5.5 (P4), U1.39 (PC4)
/PC5: J5.6 (P5), U1.40 (PC5)
/PC6: J5.7 (P6), U1.41 (PC6)
/PC7: J5.8 (P7), U1.42 (PC7)
/PD0: J6.1 (P0), U1.25 (PD0)
/PD1: J6.2 (P1), U1.26 (PD1)
/PD2: J6.3 (P2), U1.27 (PD2)
/PD3: J6.4 (P3), U1.28 (PD3)
/PD4: J6.5 (P4), U1.29 (PD4)
/PD5: J6.6 (P5), U1.30 (PD5)
/PD6: J6.7 (P6), U1.31 (PD6)
/PD7: J6.8 (P7), U1.32 (PD7)
/PE0: J2.2 (TX), J7.1 (P0), R1.1, R7.2, U1.2 (PE0)
/PE1: J1.1 (MISO), J2.1 (RX), J7.2 (P1), U1.3 (PE1), U3.7 (RXD)
/PE2: J7.3 (P2), U1.4 (PE2)
/PE3: J7.4 (P3), U1.5 (PE3)
/PE4: J7.5 (P4), U1.6 (PE4)
/PE5: J7.6 (P5), U1.7 (PE5)
/PE6: J7.7 (P6), U1.8 (PE6)
/PE7: J7.8 (P7), U1.9 (PE7)
/PF0: J8.1 (P0), U1.61 (PF0)
/PF1: J8.2 (P1), U1.60 (PF1)
/PF2: J8.3 (P2), U1.59 (PF2)
/PF3: J8.4 (P3), U1.58 (PF3)
/PF4: J8.5 (P4), U1.57 (PF4)
/PF5: J8.6 (P5), U1.56 (PF5)
/PF6: J8.7 (P6), U1.55 (PF6)
/PF7: J8.8 (P7), U1.54 (PF7)
/PG0: J9.1 (P0), U1.33 (PG0)
/PG1: J9.2 (P1), U1.34 (PG1)
/PG2: J9.3 (P2), U1.43 (PG2)
/PG3: J9.4 (P3), U1.18 (PG3)
/PG4: J9.5 (P4), U1.19 (PG4)
//RESET: C1.2, J1.5 (/RESET), J14.5 (P4), R3.2, U1.20 (~RESET)
GND: C2.2, C3.2, C4.2, C5.2, C6.2, C7.2, C8.2, C9.2, C10.2, C11.2, C12.2, C13.2, D1.1 (K), D2.1 (K), D3.1 (K), D4.1 (K), J1.6 (GND), J2.5 (GND), J10.5 (P4), J10.6 (P5), J10.7 (P6), J10.8 (P7), J11.A1 (GND), J11.A12 (GND), J11.B1 (GND), J11.B12 (GND), J11.S1 (SHIELD), J14.6 (P5), R8.2, R9.2, U1.22 (GND), U1.53 (GND), U1.63 (GND), U2.4 (GND), U3.3 (GND)
unnamed: D1.2 (A), R2.2
unnamed: D2.2 (A), R4.2
unnamed: D3.2 (A), R5.2
unnamed: D4.2 (A), R6.2
unnamed: J1.4 (MOSI), R1.2
unnamed: J11.A5 (CC1), R8.1
unnamed: J11.B5 (CC2), R9.1
unnamed: C4.1, C5.1, J12.3 (P2), U2.3 (OUT)
unnamed: C13.1, J13.1 (P0)
unnamed: J13.2 (P1), U3.8 (V3)
unnamed: C2.1, U1.24 (XTAL1), Y1.2
unnamed: C3.1, U1.23 (XTAL2), Y1.1
unnamed: R7.1, U3.6 (TXD)
unnamed: J11.A6 (D+), J11.B6 (D+), U3.1 (UD+)
unnamed: J11.A7 (D-), J11.B7 (D-), U3.2 (UD-)
VCC: C6.1, C7.1, C10.1, C11.1, C12.1, J1.2 (VCC), J2.4 (VCC), J10.2 (P1), J10.3 (P2), J10.4 (P3), J12.2 (P1), J13.3 (P2), J14.2 (P1), J14.4 (P3), R3.1, U1.21 (VCC), U1.52 (VCC)
VDD: C8.1, C9.1, J10.1 (P0), J11.A4 (VBUS), J11.A9 (VBUS), J11.B4 (VBUS), J11.B9 (VBUS), J12.1 (P0), R2.1, U2.1 (IN), U3.5 (VCC)

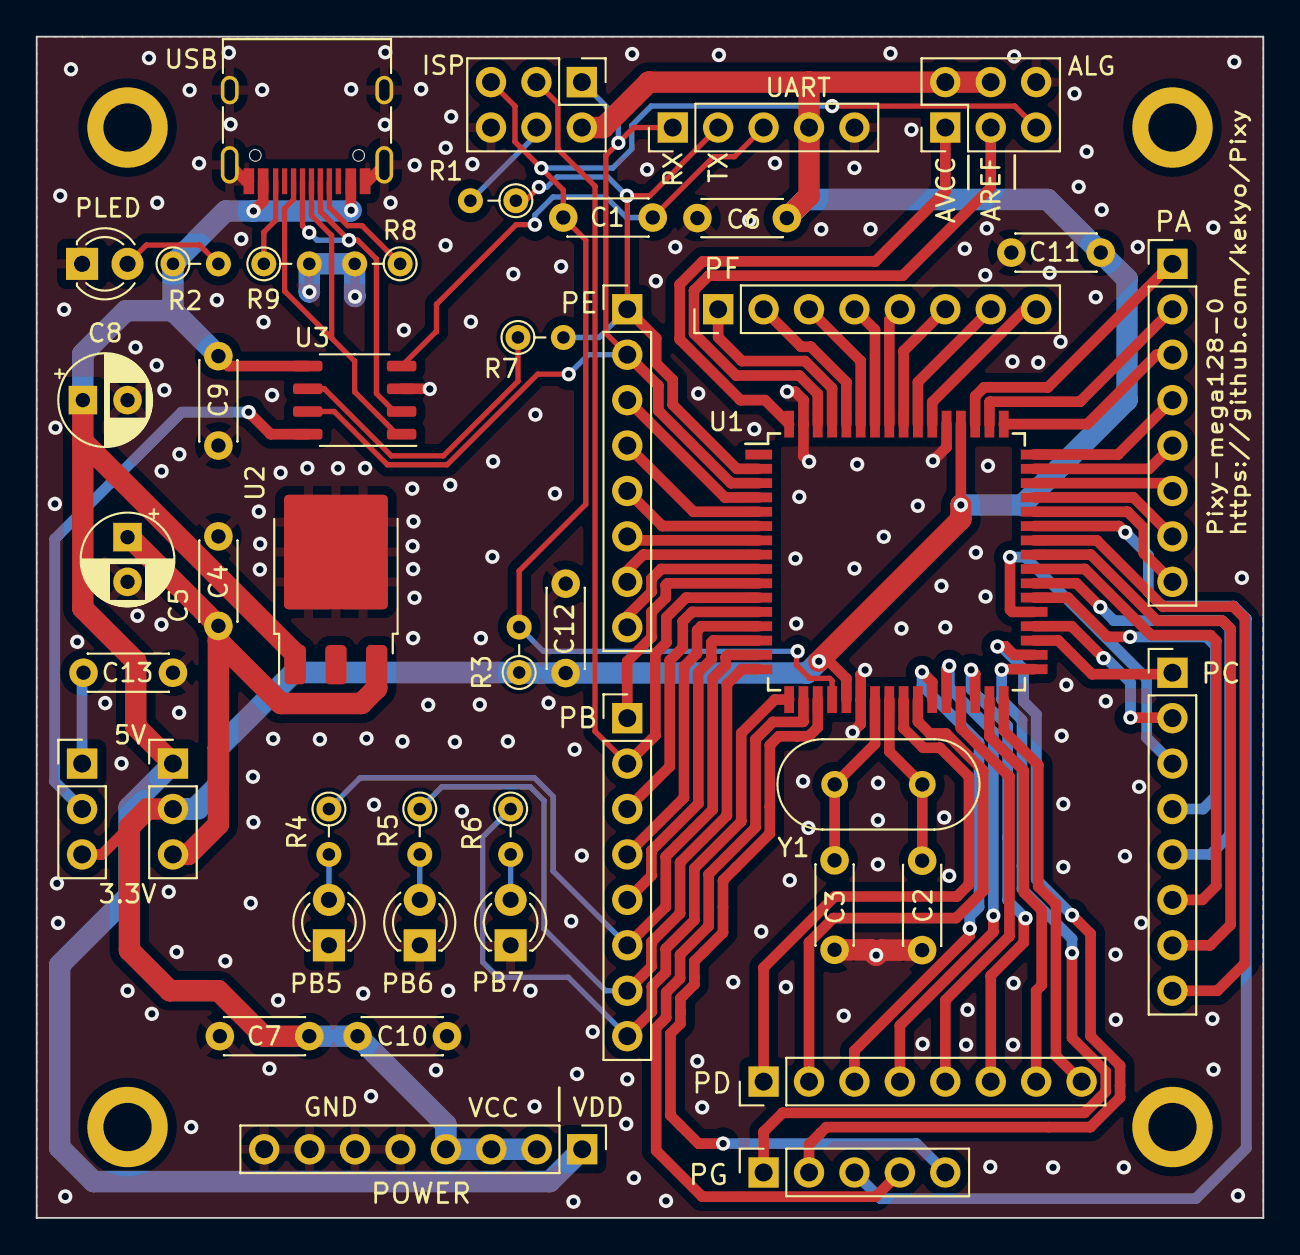
[picture p36: board Pixy-mega128.kicad_pcb from above]

Board: 2 copper layers, 68.6 x 66.0 mm, 48 parts (0 on the bottom side), 75 nets.

Other parts of the board:
REF1, REF2, REF3, REF4: MountingHole_2.7mm_M2.5_ISO7380_Pad
