kekyo/Pixy/Pixy-68000/Pixy-68000-0/KiCad/Pixy-68000.kicad_sch

## KiCad design Pixy-68000/Pixy-68000-0/KiCad/Pixy-68000.kicad_sch (2023-11-25)

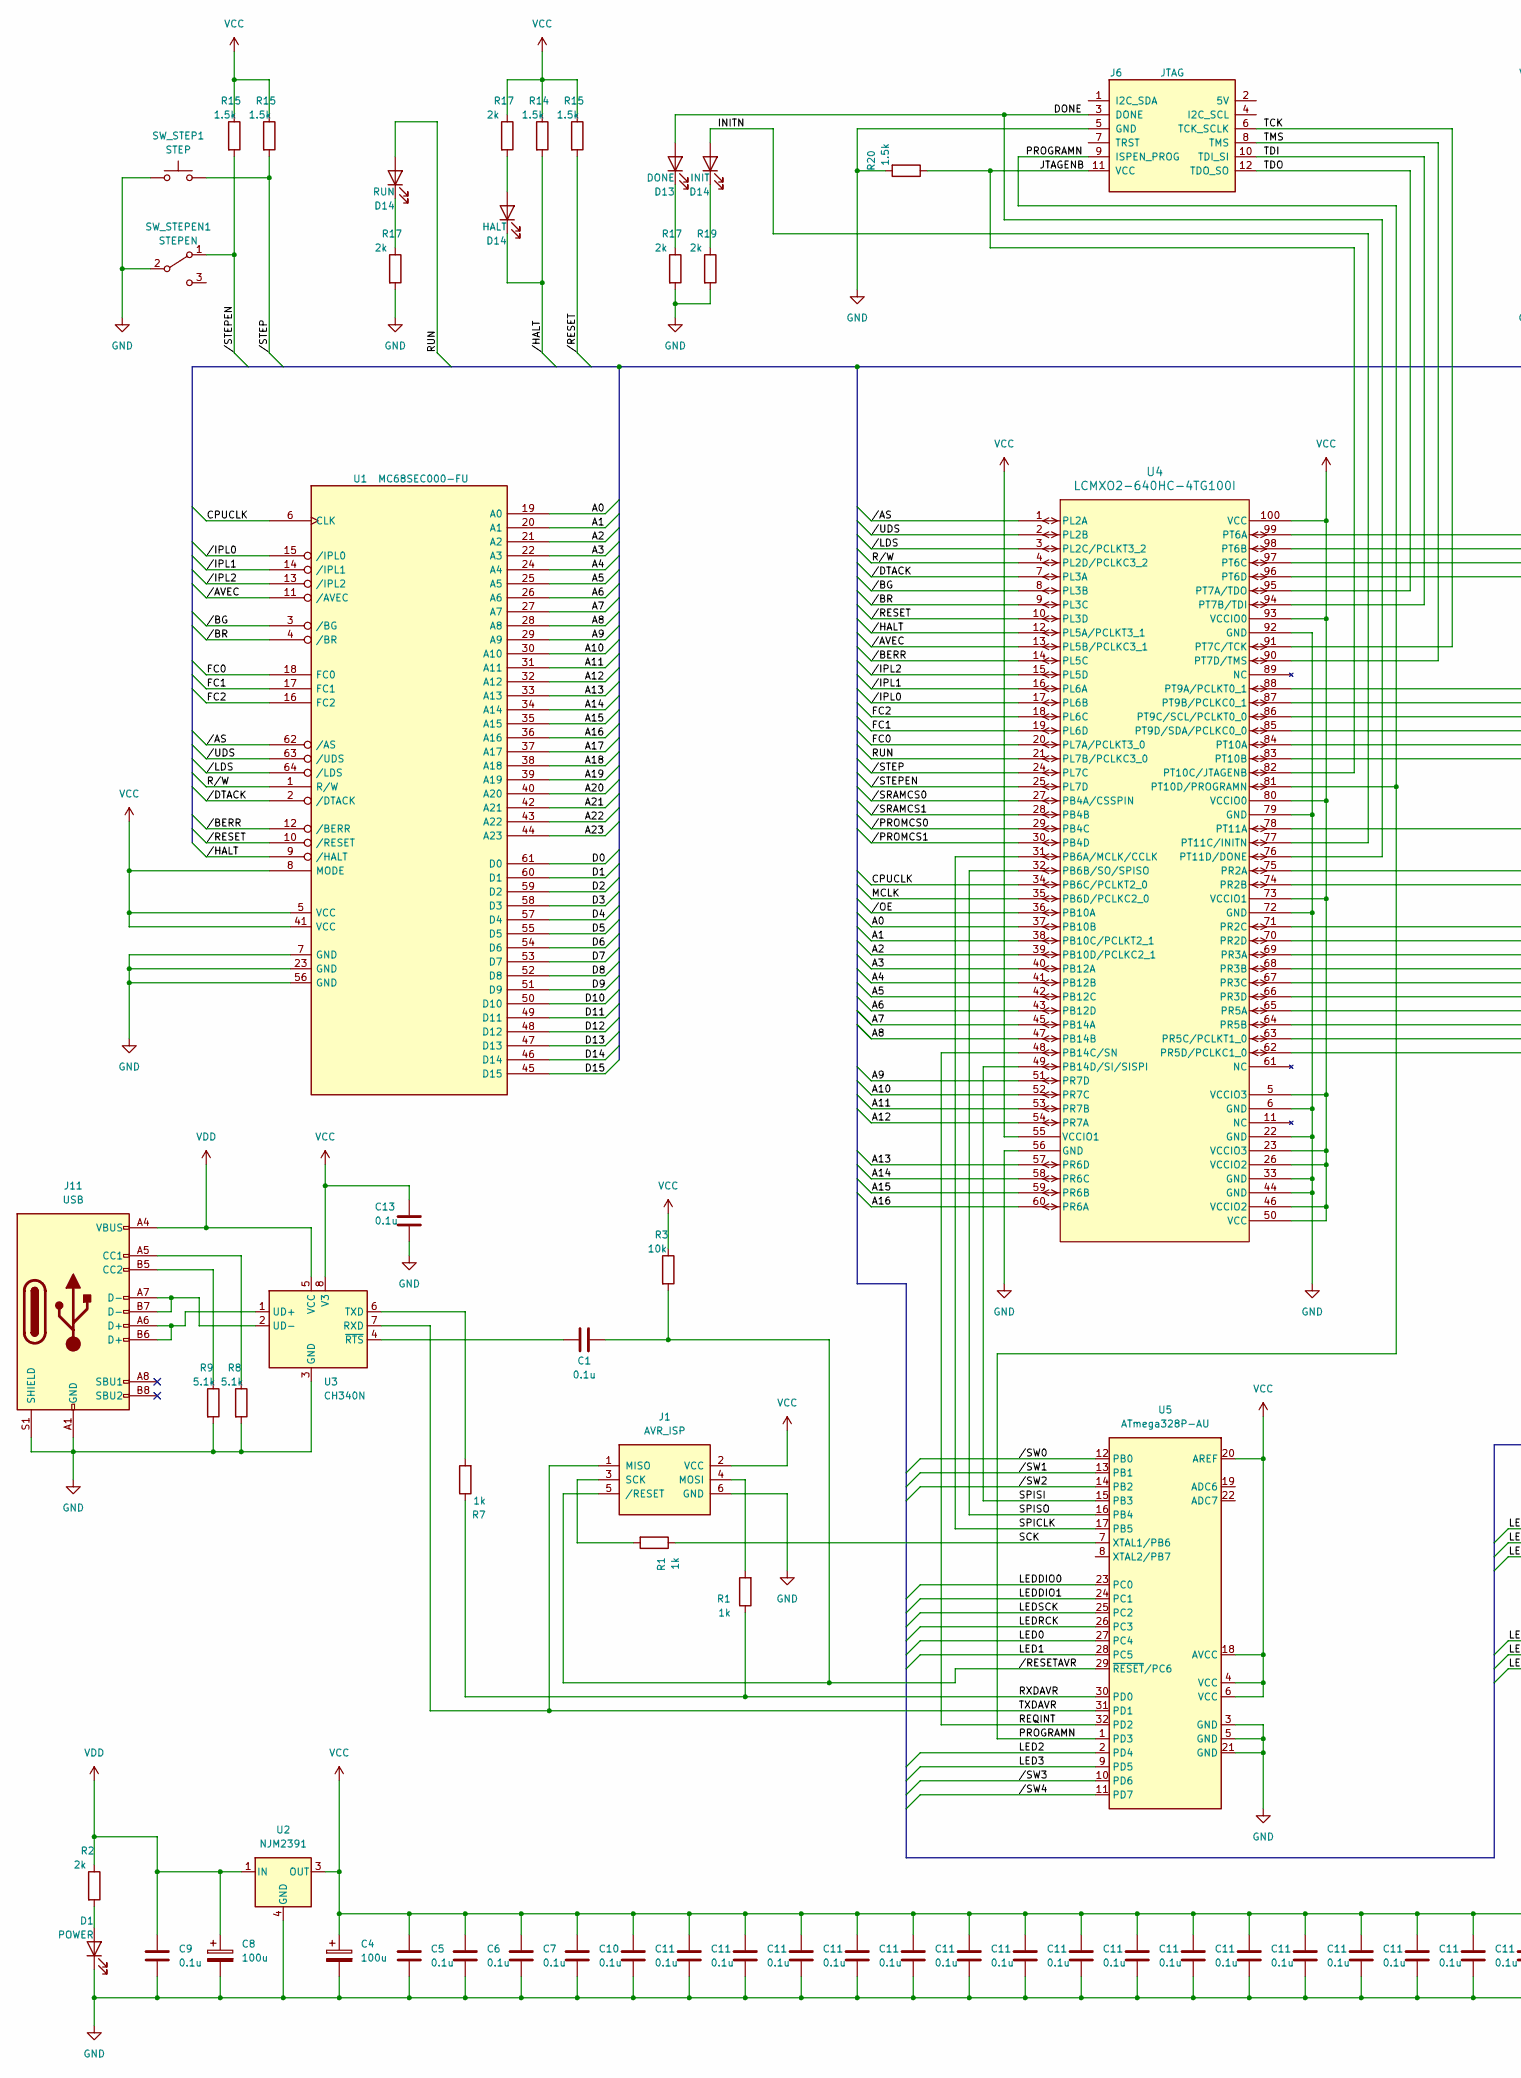
[picture p37: schematic Pixy-68000.kicad_sch, part in row 1, column 1]

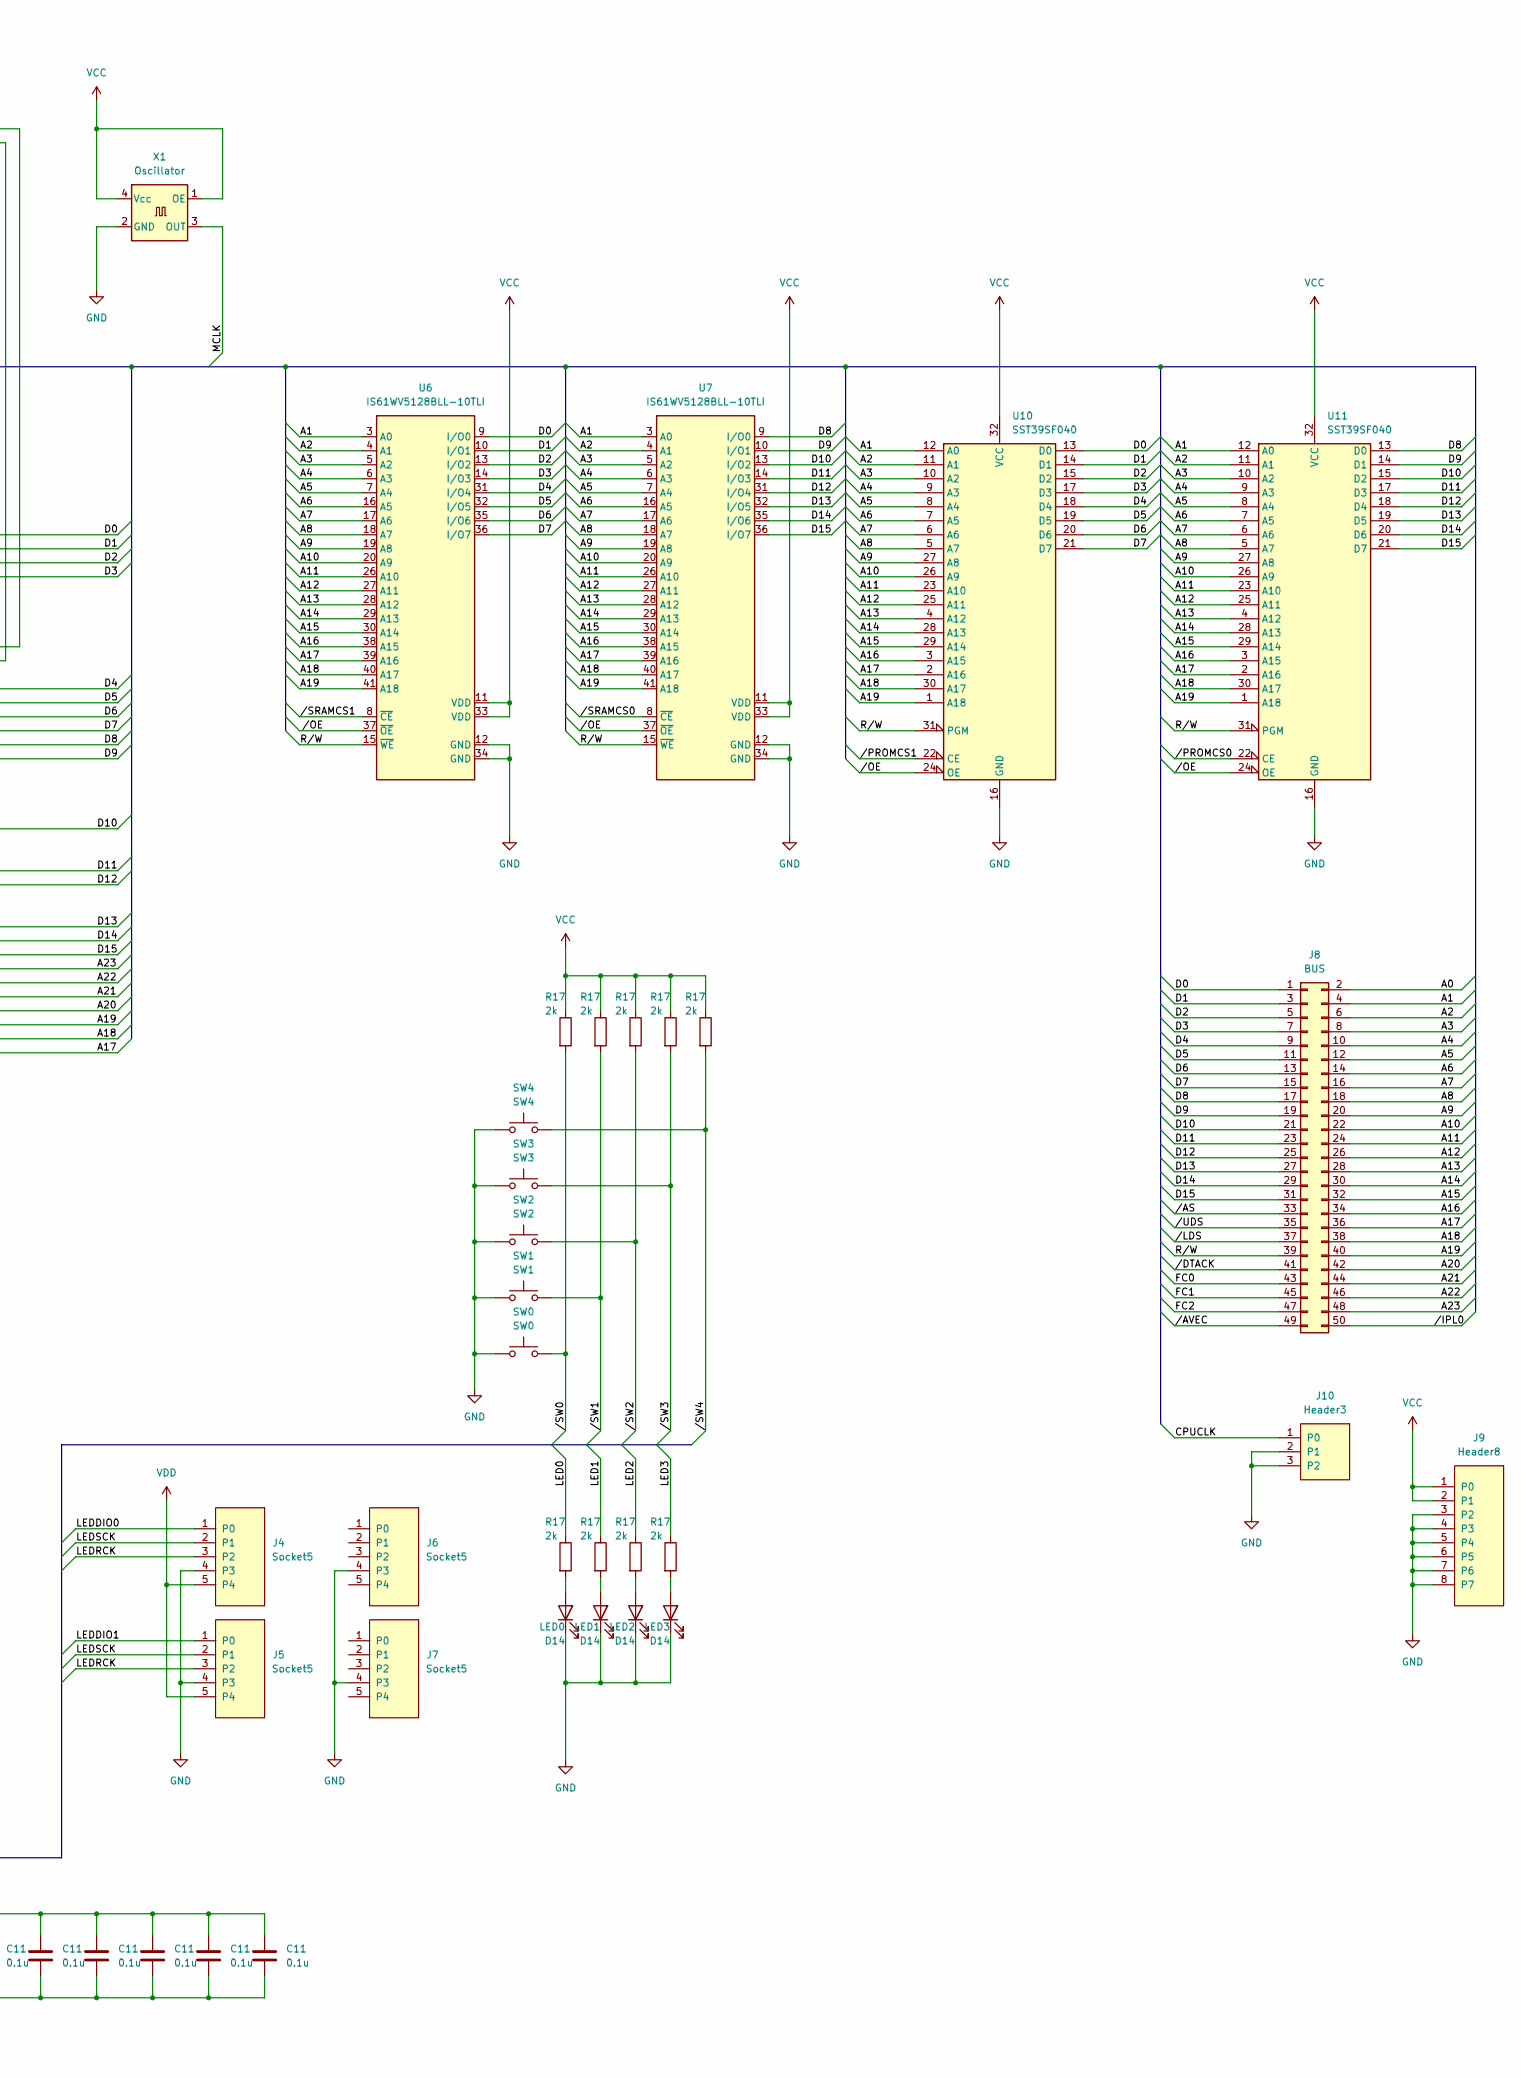
[picture p38: schematic Pixy-68000.kicad_sch, part in row 1, column 2]

Parts:
C1, C5, C6, C7, C9, C10, C11, C13: 0.1u; C_0805_2012
C4, C8: 100u; CP_Radial_D5.0mm_P2.50mm
D1: POWER; LED_D3.0mm
D13: DONE; LED_D3.0mm
D14: LED1; LED_D3.0mm
J1: AVR_ISP; PinHeader_2x03_P2.54mm_Vertical
J4, J5, J7: Socket5; PinSocket_1x05_P2.54mm_Vertical
J6: JTAG; PinHeader_2x06_P2.54mm_Vertical
J8: BUS; PinHeader_2x25_P2.54mm_Vertical
J9: Header8; PinHeader_1x08_P2.54mm_Vertical
J10: Header3; PinHeader_1x03_P2.54mm_Vertical
J11: USB; USB_C_Receptacle_HRO_TYPE-C-31-M-12
R1, R7: 1k; R_0805_2012
R2, R17, R19: 2k; R_0805_2012
R3: 10k; R_0805_2012
R8, R9: 5.1k; R_0805_2012
R14, R15, R20: 1.5k; R_0805_2012
SW0: SW0; TactSwitch
SW1: SW1; TactSwitch
SW2: SW2; TactSwitch
SW3: SW3; TactSwitch
SW4: SW4; TactSwitch
SW_STEP1: STEP; TactSwitch
SW_STEPEN1: STEPEN; SW_Toggle_3P
U1: MC68SEC000-FU
U2: NJM2391; TO-252-3_TabPin4
U3: CH340N; SOP-8_3.9x4.9mm_P1.27mm
U4: LCMXO2-640HC-4TG100I; TQFP100_LAT-M
U5: ATmega328P-AU; TQFP-32_7x7mm_P0.8mm
U6, U7: IS61WV5128BLL-10TLI; TSOP-II-44_10.16x18.41mm_P0.8mm
U10, U11: SST39SF040; PLCC-32_THT-Socket
X1: Oscillator; Oscillator_SMD_4Pin_7.0x5.0mm_HandSoldering

Connections:
A0: J8.2, U1.19 (A0), U4.37 (PB10B)
A1: J8.4, U1.20 (A1), U4.38 (PB10C/PCLKT2_1), U6.3 (A0), U7.3 (A0), U10.12 (A0), U11.12 (A0)
A2: J8.6, U1.21 (A2), U4.39 (PB10D/PCLKC2_1), U6.4 (A1), U7.4 (A1), U10.11 (A1), U11.11 (A1)
A3: J8.8, U1.22 (A3), U4.40 (PB12A), U6.5 (A2), U7.5 (A2), U10.10 (A2), U11.10 (A2)
A4: J8.10, U1.24 (A4), U4.41 (PB12B), U6.6 (A3), U7.6 (A3), U10.9 (A3), U11.9 (A3)
A5: J8.12, U1.25 (A5), U4.42 (PB12C), U6.7 (A4), U7.7 (A4), U10.8 (A4), U11.8 (A4)
A6: J8.14, U1.26 (A6), U4.43 (PB12D), U6.16 (A5), U7.16 (A5), U10.7 (A5), U11.7 (A5)
A7: J8.16, U1.27 (A7), U4.45 (PB14A), U6.17 (A6), U7.17 (A6), U10.6 (A6), U11.6 (A6)
A8: J8.18, U1.28 (A8), U4.47 (PB14B), U6.18 (A7), U7.18 (A7), U10.5 (A7), U11.5 (A7)
A9: J8.20, U1.29 (A9), U4.51 (PR7D), U6.19 (A8), U7.19 (A8), U10.27 (A8), U11.27 (A8)
A10: J8.22, U1.30 (A10), U4.52 (PR7C), U6.20 (A9), U7.20 (A9), U10.26 (A9), U11.26 (A9)
A11: J8.24, U1.31 (A11), U4.53 (PR7B), U6.26 (A10), U7.26 (A10), U10.23 (A10), U11.23 (A10)
A12: J8.26, U1.32 (A12), U4.54 (PR7A), U6.27 (A11), U7.27 (A11), U10.25 (A11), U11.25 (A11)
A13: J8.28, U1.33 (A13), U4.57 (PR6D), U6.28 (A12), U7.28 (A12), U10.4 (A12), U11.4 (A12)
A14: J8.30, U1.34 (A14), U4.58 (PR6C), U6.29 (A13), U7.29 (A13), U10.28 (A13), U11.28 (A13)
A15: J8.32, U1.35 (A15), U4.59 (PR6B), U6.30 (A14), U7.30 (A14), U10.29 (A14), U11.29 (A14)
A16: J8.34, U1.36 (A16), U4.60 (PR6A), U6.38 (A15), U7.38 (A15), U10.3 (A15), U11.3 (A15)
A17: J8.36, U1.37 (A17), U4.62 (PR5D/PCLKC1_0), U6.39 (A16), U7.39 (A16), U10.2 (A16), U11.2 (A16)
A18: J8.38, U1.38 (A18), U4.63 (PR5C/PCLKT1_0), U6.40 (A17), U7.40 (A17), U10.30 (A17), U11.30 (A17)
A19: J8.40, U1.39 (A19), U4.64 (PR5B), U6.41 (A18), U7.41 (A18), U10.1 (A18), U11.1 (A18)
A20: J8.42, U1.40 (A20), U4.65 (PR5A)
A21: J8.44, U1.42 (A21), U4.66 (PR3D)
A22: J8.46, U1.43 (A22), U4.67 (PR3C)
A23: J8.48, U1.44 (A23), U4.68 (PR3B)
CPUCLK: J10.1 (P0), U1.6 (CLK), U4.34 (PB6C/PCLKT2_0)
D0: J8.1, U1.61 (D0), U4.99 (PT6A), U6.9 (I/O0), U10.13 (D0)
D1: J8.3, U1.60 (D1), U4.98 (PT6B), U6.10 (I/O1), U10.14 (D1)
D2: J8.5, U1.59 (D2), U4.97 (PT6C), U6.13 (I/O2), U10.15 (D2)
D3: J8.7, U1.58 (D3), U4.96 (PT6D), U6.14 (I/O3), U10.17 (D3)
D4: J8.9, U1.57 (D4), U4.88 (PT9A/PCLKT0_1), U6.31 (I/O4), U10.18 (D4)
D5: J8.11, U1.55 (D5), U4.87 (PT9B/PCLKC0_1), U6.32 (I/O5), U10.19 (D5)
D6: J8.13, U1.54 (D6), U4.86 (PT9C/SCL/PCLKT0_0), U6.35 (I/O6), U10.20 (D6)
D7: J8.15, U1.53 (D7), U4.85 (PT9D/SDA/PCLKC0_0), U6.36 (I/O7), U10.21 (D7)
D8: J8.17, U1.52 (D8), U4.84 (PT10A), U7.9 (I/O0), U11.13 (D0)
D9: J8.19, U1.51 (D9), U4.83 (PT10B), U7.10 (I/O1), U11.14 (D1)
D10: J8.21, U1.50 (D10), U4.78 (PT11A), U7.13 (I/O2), U11.15 (D2)
D11: J8.23, U1.49 (D11), U4.75 (PR2A), U7.14 (I/O3), U11.17 (D3)
D12: J8.25, U1.48 (D12), U4.74 (PR2B), U7.31 (I/O4), U11.18 (D4)
D13: J8.27, U1.47 (D13), U4.71 (PR2C), U7.32 (I/O5), U11.19 (D5)
D14: J8.29, U1.46 (D14), U4.70 (PR2D), U7.35 (I/O6), U11.20 (D6)
D15: J8.31, U1.45 (D15), U4.69 (PR3A), U7.36 (I/O7), U11.21 (D7)
DONE: D13.2 (A), J6.3 (P2), U4.76 (PT11D/DONE)
FC0: J8.43, U1.18 (FC0), U4.20 (PL7A/PCLKT3_0)
FC1: J8.45, U1.17 (FC1), U4.19 (PL6D)
FC2: J8.47, U1.16 (FC2), U4.18 (PL6C)
GND: C4.2, C5.2, C6.2, C7.2, C8.2, C9.2, C10.2, C11.2, C13.2, D1.1 (K), D14.1 (K), J1.6 (GND), J4.4 (P3), J5.4 (P3), J6.4 (P3), J6.5 (P4), J7.4 (P3), J9.3 (P2), J9.4 (P3), J9.5 (P4), J9.6 (P5), J9.7 (P6), J9.8 (P7), J10.2 (P1), J10.3 (P2), J11.A1 (GND), J11.A12 (GND), J11.B1 (GND), J11.B12 (GND), J11.S1 (SHIELD), R8.2, R9.2, R17.2, R19.2, R20.2, SW0.1, SW1.1, SW2.1, SW3.1, SW4.1, SW_STEP1.1, SW_STEPEN1.2 (B), U1.7 (GND), U1.23 (GND), U1.56 (GND), U2.4 (GND), U3.3 (GND), U4.6 (GND), U4.22 (GND), U4.33 (GND), U4.44 (GND), U4.56 (GND), U4.72 (GND), U4.79 (GND), U4.92 (GND), U5.3 (GND), U5.5 (GND), U5.21 (GND), U6.12 (GND), U6.34 (GND), U7.12 (GND), U7.34 (GND), U10.16 (GND), U11.16 (GND), X1.2 (GND)
INITN: D14.2 (A), U4.77 (PT11C/INITN)
JTAGENB: J6.11 (VCC), R20.1, U4.82 (PT10C/JTAGENB)
LED0: R17.1, U5.27 (PC4)
LED1: R17.1, U5.28 (PC5)
LED2: R17.1, U5.2 (PD4)
LED3: R17.1, U5.9 (PD5)
LEDDIO0: J4.1 (P0), U5.23 (PC0)
LEDDIO1: J5.1 (P0), U5.24 (PC1)
LEDRCK: J4.3 (P2), J5.3 (P2), U5.26 (PC3)
LEDSCK: J4.2 (P1), J5.2 (P1), U5.25 (PC2)
MCLK: U4.35 (PB6D/PCLKC2_0), X1.3 (OUT)
unnamed: C1.1, U3.4 (~RTS)
unnamed: D1.2 (A), R2.2
unnamed: D13.1 (K), R17.1
unnamed: D14.1 (K), R17.1, R19.1
unnamed: D14.2 (A), R17.2
unnamed: J1.3 (SCK), R1.2
unnamed: J1.4 (MOSI), R1.2
unnamed: J11.A5 (CC1), R8.1
unnamed: J11.A6 (D+), J11.B6 (D+), U3.1 (UD+)
unnamed: J11.A7 (D-), J11.B7 (D-), U3.2 (UD-)
unnamed: J11.B5 (CC2), R9.1
unnamed: R7.2, U3.6 (TXD)
PROGRAMN: J6.9 (ISPEN_PROG), U4.81 (PT10D/PROGRAMN), U5.1 (PD3)
REQINT: U4.48 (PB14C/SN), U5.32 (PD2)
RUN: D14.2 (A), U4.21 (PL7B/PCLKC3_0)
RXDAVR: R1.1, R7.1, U5.30 (PD0)
R/W: J8.39, U1.1 (R/W), U4.4 (PL2D/PCLKC3_2), U6.15 (~WE), U7.15 (~WE), U10.31 (PGM), U11.31 (PGM)
SCK: R1.1, U5.7 (XTAL1/PB6)
SPICLK: U4.31 (PB6A/MCLK/CCLK), U5.17 (PB5)
SPISI: U4.49 (PB14D/SI/SISPI), U5.15 (PB3)
SPISO: U4.32 (PB6B/SO/SPISO), U5.16 (PB4)
TCK: J6.6 (TCK_SCLK), U4.91 (PT7C/TCK)
TDI: J6.10 (TDI_SI), U4.94 (PT7B/TDI)
TDO: J6.12 (TDO_SO), U4.95 (PT7A/TDO)
TMS: J6.8 (TMS), U4.90 (PT7D/TMS)
TXDAVR: J1.1 (MISO), U3.7 (RXD), U5.31 (PD1)
VCC: C4.1, C5.1, C6.1, C7.1, C10.1, C11.1, C13.1, J1.2 (VCC), J9.1 (P0), J9.2 (P1), R3.1, R14.1, R15.1, R17.1, U1.5 (VCC), U1.8 (MODE), U1.41 (VCC), U2.3 (OUT), U3.8 (V3), U4.5 (VCCIO3), U4.23 (VCCIO3), U4.26 (VCCIO2), U4.46 (VCCIO2), U4.50 (VCC), U4.55 (VCCIO1), U4.73 (VCCIO1), U4.80 (VCCIO0), U4.93 (VCCIO0), U4.100 (VCC), U5.4 (VCC), U5.6 (VCC), U5.18 (AVCC), U5.20 (AREF), U6.11 (VDD), U6.33 (VDD), U7.11 (VDD), U7.33 (VDD), U10.32 (VCC), U11.32 (VCC), X1.1 (OE), X1.4 (Vcc)
VDD: C8.1, C9.1, J4.5 (P4), J5.5 (P4), J11.A4 (VBUS), J11.A9 (VBUS), J11.B4 (VBUS), J11.B9 (VBUS), R2.1, U2.1 (IN), U3.5 (VCC)
/AS: J8.33, U1.62 (/AS), U4.1 (PL2A)
/AVEC: J8.49, U1.11 (/AVEC), U4.13 (PL5B/PCLKC3_1)
/BERR: U1.12 (/BERR), U4.14 (PL5C)
/BG: U1.3 (/BG), U4.8 (PL3B)
/BR: U1.4 (/BR), U4.9 (PL3C)
/DTACK: J8.41, U1.2 (/DTACK), U4.7 (PL3A)
/HALT: D14.1 (K), R14.2, U1.9 (/HALT), U4.12 (PL5A/PCLKT3_1)
/IPL0: J8.50, U1.15 (/IPL0), U4.17 (PL6B)
/IPL1: U1.14 (/IPL1), U4.16 (PL6A)
/IPL2: U1.13 (/IPL2), U4.15 (PL5D)
/LDS: J8.37, U1.64 (/LDS), U4.3 (PL2C/PCLKT3_2)
/OE: U4.36 (PB10A), U6.37 (~OE), U7.37 (~OE), U10.24 (OE), U11.24 (OE)
/PROMCS0: U4.29 (PB4C), U11.22 (CE)
/PROMCS1: U4.30 (PB4D), U10.22 (CE)
/RESET: R15.2, U1.10 (/RESET), U4.10 (PL3D)
/RESETAVR: C1.2, J1.5 (/RESET), R3.2, U5.29 (~RESET/PC6)
/SRAMCS0: U4.27 (PB4A/CSSPIN), U7.8 (~CE)
/SRAMCS1: U4.28 (PB4B), U6.8 (~CE)
/STEP: R15.2, SW_STEP1.2, U4.24 (PL7C)
/STEPEN: R15.2, SW_STEPEN1.1 (A), U4.25 (PL7D)
/SW0: R17.2, SW0.2, U5.12 (PB0)
/SW1: R17.2, SW1.2, U5.13 (PB1)
/SW2: R17.2, SW2.2, U5.14 (PB2)
/SW3: R17.2, SW3.2, U5.10 (PD6)
/SW4: R17.2, SW4.2, U5.11 (PD7)
/UDS: J8.35, U1.63 (/UDS), U4.2 (PL2B)
