kekyo/Pixy/Pixy-68000/Fpga/ClockDivider.v

module ClockDivider(
    input MCLK_IN,
	input RESET_ALL_IN,
    output reg CPUCLK,
    output reg TIMERCLK);

/////////////////////////////////////////////

reg [5:0] DIV_COUNT;

// CLK_IN=40MHz  (25ns)
always @ (posedge MCLK_IN, posedge RESET_ALL_IN) begin
	if (RESET_ALL_IN) begin
        DIV_COUNT <= 6'd0;
	end else if (DIV_COUNT == 6'd0) begin
        DIV_COUNT <= 6'd0;      // 20MHz = 2 * 25ns
        //DIV_COUNT <= 6'd63;
        CPUCLK <= ~CPUCLK;
    end else begin
        DIV_COUNT <= DIV_COUNT - 6'd1;
    end
end

/////////////////////////////////////////////

reg [4:0] TIMER_COUNT;

// CLK_IN=40MHz  (25ns)
always @ (posedge MCLK_IN, posedge RESET_ALL_IN) begin
	if (RESET_ALL_IN) begin
        TIMER_COUNT <= 5'd0;
	end else if (TIMER_COUNT == 5'd0) begin
        TIMER_COUNT <= 5'd20;    // 1MHz = 40 * 25ns
        TIMERCLK <= ~TIMERCLK;
    end else begin
        TIMER_COUNT <= TIMER_COUNT - 5'd1;
    end
end

endmodule
