kekyo/Pixy/Pixy-68000/Fpga/Reset.v

module Reset(
    input MCLK_IN,
	input RESET_ALL_IN,
    output reg RESET,
	output reg HALT,
	output reg RUN);

////////////////////////////////////////////////////

// Reset waiting counter.
reg [16:0] RESET_COUNT;

// Reset control.
always @ (posedge MCLK_IN, posedge RESET_ALL_IN) begin
	if (RESET_ALL_IN) begin
		RESET <= 1'b1;
		HALT <= 1'b1;
		RUN <= 1'b0;
		RESET_COUNT <= 17'd0;
	end else if (RESET_COUNT == 17'd100000) begin    // 1us/1MHz=100000 --> 100ms
		RESET <= 1'b0;
		HALT <= 1'b0;
		RUN <= 1'b1;
    end else begin
		RESET <= 1'b1;
		HALT <= 1'b1;
		RUN <= 1'b0;
		RESET_COUNT <= RESET_COUNT + 17'd1;
    end
end

endmodule
