kekyo/Pixy/(commit log)

2023-10-29 Initial commit with Pixy-mega128-0
    [Pixy-mega128-B_Cu.gbl, Pixy-mega128-B_Mask.gbs, Pixy-mega128-B_Paste.gbp, Pixy-mega128-B_Silkscreen.gbo, Pixy-mega128-Edge_Cuts.gm1, Pixy-mega128-F_Cu.gtl, Pixy-mega128-F_Mask.gts, Pixy-mega128-F_Paste.gtp]
2023-10-29 Added Pixy-mega128-0-sdram-hat.
    [Pixy-mega128-0-sdram-hat-B_Cu.gbl, Pixy-mega128-0-sdram-hat-B_Mask.gbs, Pixy-mega128-0-sdram-hat-B_Paste.gbp, Pixy-mega128-0-sdram-hat-B_Silkscreen.gbo, Pixy-mega128-0-sdram-hat-Edge_Cuts.gm1, Pixy-mega128-0-sdram-hat-F_Cu.gtl, Pixy-mega128-0-sdram-hat-F_Mask.gts, Pixy-mega128-0-sdram-hat-F_Paste.gtp]
2023-11-04 Fixed lacking C3.
    [Pixy-mega128-0-sdram-hat.kicad_pcb, Pixy-mega128-0-sdram-hat.kicad_sch]
2023-11-04 Refactored directory structure.
    [Pixy-mega128-0-sdram-hat-B_Cu.gbl, Pixy-mega128-0-sdram-hat-B_Mask.gbs, Pixy-mega128-0-sdram-hat-B_Paste.gbp, Pixy-mega128-0-sdram-hat-B_Silkscreen.gbo, Pixy-mega128-0-sdram-hat-Edge_Cuts.gm1, Pixy-mega128-0-sdram-hat-F_Cu.gtl, Pixy-mega128-0-sdram-hat-F_Mask.gts, Pixy-mega128-0-sdram-hat-F_Paste.gtp]
2023-11-12 Hand routed basic connections.
    [Pixy-68000.kicad_pcb, Pixy-68000.kicad_sch]
2023-11-19 Completed artwork 68000-0.
    [Pixy-68000-B_Cu.gbr, Pixy-68000-B_Mask.gbr, Pixy-68000-B_Paste.gbr, Pixy-68000-B_Silkscreen.gbr, Pixy-68000-Edge_Cuts.gbr, Pixy-68000-F_Cu.gbr, Pixy-68000-F_Mask.gbr, Pixy-68000-F_Paste.gbr]
2023-11-22 Updated readme.
    [Pixy-mega128-0-sdram-hat-B_Cu.gbl, Pixy-mega128-0-sdram-hat-B_Mask.gbs, Pixy-mega128-0-sdram-hat-B_Paste.gbp, Pixy-mega128-0-sdram-hat-B_Silkscreen.gbo, Pixy-mega128-0-sdram-hat-Edge_Cuts.gm1, Pixy-mega128-0-sdram-hat-F_Cu.gtl, Pixy-mega128-0-sdram-hat-F_Mask.gts, Pixy-mega128-0-sdram-hat-F_Paste.gtp]
2023-11-25 Fixed bootloading JTAG signal lines on ATMega328P.
    [Pixy-68000.kicad_sch]
2023-11-26 Fixed JTAG pin header assignment.
    [Pixy-68000.kicad_sch]
2023-11-27 Improved JTAG stability.
    [Pixy-68000.kicad_sch]
2023-11-29 Bit changed.
    [Pixy-68000.kicad_sch]
2023-12-02 Added errara2 information.
    Fixed missing SPISS signal.
    [Pixy-68000.kicad_sch]
2023-12-03 Enabled stepper control.
2023-12-03 Fixed monitoring bit order.
    [Main.v]
2023-12-03 Totally checked booting from flash rom.
    [Pixy-68000.kicad_sch]
2023-12-03 Splitted both 0 and 1 version.
    [Pixy-68000-B_Cu.gbr, Pixy-68000-B_Mask.gbr, Pixy-68000-B_Paste.gbr, Pixy-68000-B_Silkscreen.gbr, Pixy-68000-Edge_Cuts.gbr, Pixy-68000-F_Cu.gbr, Pixy-68000-F_Mask.gbr, Pixy-68000-F_Paste.gbr]
2023-12-08 Removed -0 gerber on -1 directory.
    [Pixy-68000-B_Cu.gbr, Pixy-68000-B_Mask.gbr, Pixy-68000-B_Paste.gbr, Pixy-68000-B_Silkscreen.gbr, Pixy-68000-Edge_Cuts.gbr, Pixy-68000-F_Cu.gbr, Pixy-68000-F_Mask.gbr, Pixy-68000-F_Paste.gbr]
2023-12-08 Added memory selector headers.
    [Pixy-68000.kicad_sch]
2023-12-08 Implemented output signal on SPI.
2023-12-09 Implemented LED blinker.
2023-12-12 Implemented switch to LED.
2023-12-12 Switched to little endian and LSB first format on the SPI.
2023-12-16 Fixed exchanged RAM/PROM selector.
    [Pixy-68000.kicad_sch]
2023-12-18 Added uart bridge (sender).
2023-12-19 Implemented uart receiver.
2023-12-20 Changed 7segment driving with timer interruption.
2023-12-21 Added /OE pullup register.
    [Pixy-68000.kicad_sch]
2023-12-21 Finalized Pixy-68000-1 with gerber data.
    [Pixy-68000-B_Cu.gbr, Pixy-68000-B_Mask.gbr, Pixy-68000-B_Paste.gbr, Pixy-68000-B_Silkscreen.gbr, Pixy-68000-Edge_Cuts.gbr, Pixy-68000-F_Cu.gbr, Pixy-68000-F_Mask.gbr, Pixy-68000-F_Paste.gbr]
2023-12-22 Made bit-banning 7seg led driver.
2023-12-22 Improved uart echo back cycle cost.
2023-12-28 Implemented UART receive interrupt.
2023-12-29 Implemented UART send interrupt.
2023-12-29 Implemented free running counter and timer interrupt.
2024-01-02 Fixed sram_checker to apply newer signal port spec.
    [BusControl.v, Main.v, Monitor.v, Reset.v, main.cpp, sram_check.c, uart_bridge.c]
2024-01-02 Fixed did not assert DTACK when read timer counter port.
    [BusControl.v, ClockDivider.v, timer.c]
2024-01-03 Fixed invalid encoding for interrupt level bits.
    [BusControl.v]
2024-01-07 Tested printf/scanf.
2025-02-27 Implemented 68020 schematic.
    [Pixy-68020.kicad_pcb, Pixy-68020.kicad_sch]
2025-02-27 Changed MachXO2 footprint.
    [Pixy-68020.kicad_sch]
2025-02-27 Fixed minor footprint issue.
    [Pixy-68020.kicad_pcb, Pixy-68020.kicad_sch]
